jiz322/tiptoe-biped/data/p12_2_flight_20260827/README.txt

P12.2 flight recordings, 2026-08-27, policy K4b_3600 (10 trials).

Trial start condition:
- policy_K4b3600_log_20260827_164730.npz (the last one) starts WITH PICKUP
  (robot held / picked up at trial start).
- All other 9 npz files (163302 .. 164712) start ON THE GROUND.
