jiz322/tiptoe-biped/data/p12_2_flight_20260828_6pm/README.txt

P12.2-style flight recordings, 2026-08-28 ~6pm, policy R1r_3150 (8 trials).

Trial start condition:
- r1r_3150_log_20260828_180512.npz (the last one) starts WITH PICKUP
  (robot held / picked up at trial start).
- All other 7 npz files (180328 .. 180454) start ON THE GROUND.
