jiz322/tiptoe-biped/data/p12_3_flight_20260831_v/README.txt

P12.2-style flight recordings, 2026-08-31 ~15:02-15:04, policy R1r_3150 (6 trials).

Handover mode: ALL trials in this session were started with the 'v' key, NOT 'b'.
('v' = blind / training-contract handover: obs-history buffer zeroed like a
training episode start; 'b' = old deploy handover that fed the real frame x5.)

Trial start condition:
- r1r_3150_log_20260831_150405.npz (the last one) starts WITH PICKUP
  (robot held / picked up at trial start), as usual.
- All other 5 npz files (150243 .. 150352) start ON THE GROUND.
