jiz322/tiptoe-biped/data/p12_flight_20260825/README.txt

P12 flight recordings, 2026-08-25. Policies K4b_3600 (7 trials, 09:57-10:16)
and L1_4330 (5 trials, 10:37-10:38).
The day the right-knee belt tooth skip was first observed on video (after the
catch-steps on a grippy mat); see docs/p12-fall-isolation-runbook.md, whose
"forward lean" day verdict was retracted the same afternoon.

Contract at the time (see data/README.md for the decode rules):
- IMU pitch trim -0.089 (raw pg_x = logged - 0.089).
- Handover 'b' (sighted).
- IMU lateral sign constants were the OLD, mirrored set (fixed 2026-08-28).
