jiz322/tiptoe-biped/docs/p12-4-session-20260903.md

# P12.4 session report — 2026-09-03: IMU trim bracket, first sustained balance

Policy: R1r_3150 (TorchScript export of the R1r line, iter 3150), blind 'v'
handover (training contract, obs history zeroed), ground start, no pickup.
Recordings: `data/p12_4_flight_20260903_v_notrim/` (6 trials) and
`data/p12_4_flight_20260903_v_postrim/` (1 trial). Commits 423ace7 (trim 0) and
efdd12d (trim +0.089).

## 1. Decisions taken this session

- **`docs/p12-4-bench-runbook.md` abandoned by the user.** Too complex; most
  items not practically doable; designing bench experiments accurate enough
  costs days. Do not re-propose push-test / mass-added tap / video-annotation
  branches as prerequisites. The robot is now tuned empirically and flown.
- **Knee armature anomaly retracted.** The 09-01 tap frequencies (11 Hz @ kp30,
  14 Hz @ kp50) were double-counted. Corrected inertia is near the trained DR
  boundary, not 6× low. The 08-22 ballistic evidence (rotors ≈ 19e-3) stands.
- **IMU pitch trim `IMU_PG_OFFSET[0]` used as a control knob**, bracketed
  −0.089 → 0 → +0.089 in one day.

## 2. Trim bracket results

Sign rule (`control/config.py`): `pg_corrected = pg_measured − IMU_PG_OFFSET`,
so **raw pg_x = logged + OFFSET[0]**. Pitch = atan2(pg_x, −pg_z), positive =
forward. PONR25 = first crossing of 25° tilt never re-entered
(`data/_p12_3_alive_time.py` method).

| session (`data/`) | trim | raw pitch @0.2 s | plateau 0.3–0.8 s | PONR25 median | result |
|---|---|---|---|---|---|
| `p12_3_flight_20260831_v` | −0.089 | −13…−15° | −21°, rate −36°/s | 0.67 s | 5/5 fell backward |
| `p12_4_flight_20260903_v_notrim` | 0 | −10…−12° | −15°, rate −8°/s | 1.13 s | 6/6 backward, mostly tether-ended |
| `p12_4_flight_20260903_v_postrim` | **+0.089** | −6.5° | −10° | **none (6.06 s)** | **STOOD — still upright at log stop** |

Notes on the trim-0 session: the opening backward dive to ≈ −10° at 0.2 s is
trained behaviour and unchanged by trim; the trim changes the plateau
stability. Most trim-0 failures were tether-truncated (no backward room →
OOD); only trial 5 fell (backward lean) before the tether engaged.

### Post-trim trial `r1r_3150_log_20260903_134700.npz` (603 frames, 6.06 s)

- Raw pitch over 1–5.5 s: mean **−14.5°, sd 6.7°**; max tilt 34° once (3.4 s),
  never crossed 25° for good; last 0.3 s at −14°, still standing when the log
  stopped. First free-standing ground trial in the record to pass 4 s.
- Knees settled L +0.31 / R −0.32 rad (mirror signs → symmetric crouch), hips ≈ 0.
- The policy *perceives* pg_x ≈ −0.34 at that posture, close to its trained
  settled idle of −0.27 (08-25 analysis). With the old trim it held the same
  perceived value at a real pitch of −21° and toppled; now it holds it at
  −14.5° and survives → the knob places the real closed loop inside the
  policy's own basin.
- Plot: `outputs/p12_4_postrim_134700.png`.

### Right-knee belt slip (user-observed, mid-trial)

The npz cannot see slip directly (encoder is motor-side; checklist item 9),
but the data is consistent with the observation and dates it to ≈ [3.2–3.8]:

- Pitch rate −487°/s at 3.40 s; L knee |τ| 9.5 Nm motor at 3.17 s, R knee
  10.1 Nm at 3.76 s.
- Hip roll L/R in lockstep before 3 s (R − L = 0.00 ± 0.04 rad) vs a
  persistent R − L = +0.18 rad splay after 3 s; knees before L +0.242 /
  R −0.183, after L +0.326 / R −0.385 → right-leg geometry change followed by
  lateral compensation.
- The robot balanced ≈ 3 s more with one knee one tooth (12° = 0.21 rad
  joint-side) off — real robustness, and a hint about what the trim compensates.

## 3. Interpretation

- True IMU mounting offset ≈ −0.032 (08-18 crawl decomposition). The working
  trim is +0.12 past it: the policy must be told it leans ≈ 7° further back
  than it does. The trim is therefore a **plant-gap compensator, not IMU
  calibration**.
- Static CoM / mass model is **not** the lever: ≈ 0.3–0.37 kg unmodeled mass
  (W = 5.57 kg vs URDF 5.195) needs an 18 cm lever to shift CoM 1 cm; the
  knife-edge bounds |ΔCoM_x| ≲ 0.5–1 cm. Screws at the hip chassis cannot
  produce 7°. A mass-model fine-tune is not recommended.
- **Leading candidate: systematic knee joint-angle bias vs encoder** (belt
  slip / stretch / crawl-zero error). 12° knee × 0.2 m shank ≈ 4 cm foot
  displacement — the right magnitude, and tooth skips are observed.
  Independent check: Kinovea knee marker vs `sim_joint_pos`.
- Training-distribution holes found in `rl_env_cfg_p6.py` / `rl_env_p6.py`:
  `dr_com_offset_max = 0.015` is sampled **per link, per axis, independently**
  (`_dr_com_offset` shape `(num_reset, n_bodies, 3)`), so whole-body CoM_x std
  is ≈ 3–4 mm and never a coherent shift; `dr_mass_mult` 0.94–1.18 is
  location-less; `dr_proj_grav_bias_max = 0.10` is below the working +0.12.

## 4. Next steps (user-run hardware; n = 1 today)

1. Re-seat/re-tension the right knee belt; crawl-pose zero check before every
   trial (mandatory since 08-25).
2. 5–6 repeats at +0.089 for a survival number.
3. One bracket step at +0.13 (pre-registered: expect some degradation — that is
   +0.16 vs true mounting, past the trained ±0.10 band). Goal: find the forward
   edge, deploy at the window center.
4. Give the robot backward room (tether ended most trim-0 trials).
5. Retrain per the accumulated directive (memory `next-training-directive`):
   coherent whole-body CoM_x DR ±2–3 cm; per-leg knee-angle-bias DR ±0.1–0.2
   rad; static-lean reset DR at zero rate (fixed-point dead zone); handover
   contract randomization; `dr_proj_grav_bias_max ≥ 0.12`; mass recenter
   ×1.072. Continue from the R1r checkpoint and re-pass every override on
   resume.

## 5. Housekeeping done

- `CLAUDE.md` checklist item 8 rewritten: trim history and the per-folder
  raw-decode rule (−0.089 before 09-03; 0 for `_v_notrim`; +0.089 from
  `_v_postrim` onward).
- Memory updated: `p12-4-notrim-flight` (bracket table + belt-slip window +
  knee-bias hypothesis), `p12-4-decision-tree` (abandoned; surviving facts),
  `knee-armature-tap-contradiction` (retracted), `next-training-directive`
  (items 4–6 added).
- **Not done:** the comment block above `IMU_PG_OFFSET` in
  `control/config.py` (~lines 214–258) still says "STAYS −0.089" and is stale;
  left untouched because the file is deployed on the Pi at a pinned commit.
  Rewrite it at the next commit.
