jiz322/tiptoe-biped/docs/replant-report-20260817.html

# Replant Bench Report

Execution report against the Replant Runbook — what was measured, what died, what leads.

DATE 2026-08-17 → 08-18 (4 sessions + review) TAG pre-replant-20260817 BUS CAN2SPI, zero pacing ROBOT big_thigh biped, tether-hung (no stand — see review)

Four bench sessions executed runbook Phases 0–6. The headline: the plant's latency panel is an order of magnitude faster than every number the sim was calibrated against, and every mechanistic plant-side fall suspect died under measurement — the spd_filt_gain kd-lag hypothesis, the EL05 reference filter, and the RS01 current-clamp torque ceiling. What survives: the partial static bias and the un-caught launch transient.

A pre-Phase-7 review pass (08-18, no reruns) then audited all of it. Read the Phases 0–6 review before writing anything into the cfg: three claims above are corrected there, armature turns out to be the gating unmeasured field, and the viscous-friction DR band is 7× too narrow to contain the measured joint — itself a live candidate for the plant gap this campaign is hunting.

## Scoreboard phases 0–6 closed reviewed 08-18 — 7 corrections, 2 DR bands wrong

Phases 0–6 were re-audited on 08-18 against the raw captures without re-running any hardware. Chips below record what each session concluded; the review section records what survived that audit, and it revises seven published claims. Read the two together — three “closed” chips are ahead of their evidence, and the largest finding of the audit (viscous DR bands sitting below the measured plant) is new, not a restatement.

Phase | Item | Outcome
0 | Preflight | CLOSED — freeze tag, decode verified on hardware, six-motor firmware dump
1 | Loop timing | CLOSED — action 2.4–2.8 ms, IMU skew 2.0 ms, soak 100.00%
2 | Velocity / reference filters | CLOSED — kd filter ~0.7 ms (hypothesis dead); EL05 ref filter not live
3 | Torque ceiling & speed envelope | M3.1 CLOSED (ballistic probe, no load rig): full delivery to 17 Nm, clamp hypothesis dead. M3.2 envelope deferred — launch speeds sit deep inside it
4 | Step-response re-sysid | CLOSED (session 2, kp-sweep) — act_lag phantom on all three joints; ring is the kp-servo mode; no firmware loop lag on RS01, ≤13 ms confounded lag on hip_roll (stand compliance)
5 | Friction, inertia (bench) | CLOSED (session 3) — commanded-τ breakaway + M3.1-envelope ballistic fits; inertia "conflict" resolved as method bias; friction centrals measured; knee belt-off split pending
6 | Mass/balance | CLOSED (session 4, 08-18) — weigh-in +5.9% → recenter dr_mass_mult; init_h already fixed (0.4401, z=−0.01σ); straightedge declined (zero unverifiable) → substituted crawl-pose IMU decomposition: the −0.089 pg trim over-corrects by ~0.057; supine cross-check pending
7–9 | Env edits → replica gate → retrain | BLOCKED on 4–6; the P7 edit list shrank today

## Phase 0 — Preflight closed

- Freeze: ~100 uncommitted files snapshotted; tag pre-replant-20260817 (commit 500032b); all fitted numbers attributable.
- Velocity decode (the June ×1.136 bug): verified fixed on hardware, both motor families. Integral-method consistency: k = 0.9995 (RS01) / 1.0014 (EL05) — PASS at <0.2%. The naive slope regression read 2.03% and would have false-alarmed; timestamp jitter dilutes regression slopes (measurement-trap lesson re-confirmed).
- Reply pacing item was stale: superseded 08-16 by Phase D — each motor replies on its own ID, CAN2SPI_PACING_S = 0.0, and the bring-up guard verified 6/6 distinct live. Runbook text corrected.
- Firmware dump, all six motors, on the new bus (fw_livedump_all6_20260817.txt): zero per-unit spread. spd_filt_gain 0.100 ×4 RS01 / 0.500 ×2 EL05; limit_cur 23 A ×4 / 11 A ×2; zero faults. VBUS 30.2–30.65 V idle — the appendix's "~31.8 V, recheck" resolves to: the 30 V envelope assumption was right.

### New protocol facts (bank these)

- MIT-mode firmware ignores private-protocol extended frames even on CAN2SPI — the June finding was firmware behavior, not the USB adapter. Reads/writes require the protocol round-trip with a power cycle each way.
- spd_filt_gain is live-readable at runtime index 0x7021 (verified against the vendor CSVs). loc_ref_filt_gain has no CAN-reachable mirror at all (full scan 0x7000–0x7037) — vendor-tool-only.
- Vendor tool CSV export is broken → new verification path: read/set values in the GUI, verify over CAN with robstride_param_read.py (now speaks SocketCAN, has a guarded RAM-write mode).

## Phase 1 — Loop timing on CAN2SPI closed

Every CAN2USB-era number in cfg §12b is dead. The new plant is fast:

Measurement | Old assumption | Measured | Feeds
M1.1 action → motion onset, hip_pitch | 15 ms | 2.36 ms mean, 2.82 p95 (σ 0.36) | dr_action_delay → unchanged at 1 / 2 (⌈2.4 ms/10 ms⌉ = 1)
… knee (belt adds ~0.4 ms) | | 2.80 ms mean, 3.49 p95 (50/50 reps)
… hip_roll | | 2.62 ms mean, 4.36 p95
M1.2 encoder staleness vs IMU | IMU leads by 10 ms | IMU leads by 1.96 ms (corr 0.96) | dr_joint_delay 2 → 1 (skew is 0.2 tick, not 1); dr_imu_delay stays 1
M1.3 tick health, 600 s full traffic | — | 59,992 ticks, 100.00% replies, jitter p99 0.022 ms, busy p50 2.37 ms | accept ✓

Acceptance gates passed with wide margin (p95−p05 onset spread ≈ 1 ms vs the 10 ms control step). The hand-held roll rerun was discarded — hand resistance produced a 15 ms / 2 ms direction asymmetry, a useful reminder that the fits assume a free limb.

One flag from the soak: a single tick stalled 94 ms in the nn (policy inference) phase — 0.0017% of ticks, far under the 0.1% gate, and too rare to explain deterministic 0.16 s falls. Still: a ~9-period stall mid-launch would hurt. Recommend torch allocator / GC hardening before flight (Phase 10 list).

## Phase 2 — Filters closed spd_filt hypothesis

M2.1 verdict — three independent measurements agree The RS01 spd_filt_gain=0.1 EMA runs at the current-loop rate (~13 kHz): a 0.70 ms, |H|≈1.00 filter, flat to 25 Hz, corner ≈230 Hz — transparent where the balance loop lives. (1) M1.2 cross-correlation: telemetry velocity trails the position-derivative by 0.70 ms. (Review: raw arrays not retained; the M1.2 claim itself reads 1.96 ms. Unauditable — do not count.) (2) Chirp lock-in: 0.70 ms constant group delay at every frequency, both kd passes. (Review: independently reproduced at 0.704 ms ± 0.041 over 13 dwells. This one measurement carries the verdict, and it is enough.) (3) kd brake test: undershoot 3.4% at kd=2, none at kd=0.5, against a ≥13.6% counterfactual. (Review: 3.4% sits under 2 velocity LSBs and ~6× below the run's own 22% noise floor; the two kd conditions are statistically indistinguishable and the counterfactual collapses to ~0 at the engaged inertia. Withdrawn.)

- M2.2 (firmware A/B): moot. Nothing to raise; sim and firmware are already "matched" — the filter is negligible on both sides. No vendor-tool writes.
- M2.3 (EL05 loc_ref_filt_gain=0.04): not live in MIT mode. Position-step responses show no 20–50 ms filter. (Review 08-18: the published “1.7% rms, filter fitted to exactly 0 ms” does not reproduce — refit gives 21.6% rms with the prefilter pole pinned at its bound. The conclusion survives on a weaker basis: 27 ms of fitted rise buys only 0.4% of residual.) The hip_roll "most ring, lowest ω" act_lag fit is therefore an old-bus artifact — Phase 4's refit should confirm.
- Bonus physics retracted 08-18 — as published: hip_pitch inertia 8.48e-3 kg·m², “independently validating” the cfg's 8.4e-3 combined armature, pendulum stiffness 4.73 Nm/rad (3.8 Hz). Do not use. The real chirp pins stiffness at exactly 0.000 at 28–32% residual, and the quoted pair matches the fitter self-test's synthetic truth to 0.3%. Engaged hip inertia is 31e-3 (P5). See the review.

### Methodology notes for the remaining phases

- Hand-held-base data breaks rigid-plant fits (FRF chirp 28% rms, step control-fit 32%). If a test needs the torso held, design it so the discriminator lives in the first ~10 ms (brake test), or fixture the robot.
- Time-domain bounding beat FRF fitting on this rig: stiction (C ≈ 0.1–0.3 Nm, amplitude-dependent) and a rest equilibrium only known to ±40 mrad poison small-signal frequency-domain work.
- Synthetic self-tests first: the kd fit pipeline was validated on simulated data with known truth before touching real data — kept a sign-convention bug from becoming a wrong conclusion.

## Hypothesis board after today

Fall-cause candidate | Status | Evidence
kd-path velocity filter (spd_filt) | dead 08-17 | 0.7 ms, three independent measurements (this report)
Launch / IMU / DR coverage | dead 08-13 | hw-matched sim survives 6 s
Torque delivery softness (0.59–0.66) | dead 08-14 | telemetry artifact
Static balance-point bias (+0.075) | demoted 08-18 | P6 crawl-pose decomposition: ~0.057 of it is IMU-trim over-correction (hand-held-derived −0.089 vs crawl-derived −0.032 mounting); physical CoM residual ≈ +0.018, inside DR. Was already insufficient alone (≤5% die <0.5 s). Supine cross-check pending
RS01 current clamp: 12.9 Nm real vs 17 modeled | dead 08-17 | Ballistic torque probe (bursts vs known inertia): delivered tracks commanded 1:1 from 4→17 Nm, α/τ constant with no break at 12.9 — full delivery in the launch-relevant transient regime. Effective Kt ≈ 0.74 Nm/A, not the 0.562 used in the 23 A × Kt arithmetic. saturation_effort 17/23.2 validated. (Sustained-stall thermal derating not probed; no falls-relevant mechanism.)
Rotor off-diagonal belt coupling + 4× armature | LEAD (P7, 08-18) | Missing hip torque the size of the hip's own commands, peaking at the 0.161 s fall-initiation window (fall-log replay); requires two-joint acceleration — invisible to every single-joint bench. With it in the plant, hw_matched flips from surviving 6 s to 512/512 pitch-first falls, 83% one-signed in the hardware direction (Phase 8 first pass). Timing spread still wider than hardware's 0.25 s cluster.
Un-caught launch transient | open, demoted | still a candidate for the residual timing mismatch; no longer needed to explain the fall itself

## Phase 7 edit list — updated sources

Field | Now in cfg | New source
dr_action_delay_min/max | 1 / 2 | KEEP 1 / 2. Corrected: an earlier draft here read “0 / 1”, which is wrong twice over. The runbook's own mapping rule is min = measured floor rounded up, max = floor + 1 step, and ⌈2.36/10⌉ = 1 → 1 / 2. Separately, min=0 would revert a deliberate change (rl_env_cfg_p6.py:946, “was 0 — never instant”): a 10 ms control period plus 2.4–2.8 ms transport is never a zero-delay path, and letting the sim sample 0 lets the policy learn a reflex hardware cannot honor. M1.1 shrinks the old 15 ms assumption to ~2.4 ms, but both round into the same 1-step bucket, so the tap does not move.
dr_imu_delay_* | 1 / 1 | KEEP 1 / 1. Locked at 1 on purpose (:951-953 — a zero-latency balance loop was the 2 Hz wobble). M1.2 does not challenge it.

dr_joint_delay_*

2 / 2

2 → 1 / 1. This is the one delay tap M1.2 actually moves. The cfg holds joint at 2 explicitly “so encoder feedback stays ~10 ms behind the IMU, matching the measured skew” (:956-958) — but that rationale predates M1.2. The measured skew is 1.96 ms, not 10 ms: 0.2 of a tick, which rounds to no relative offset. Carrying joint one full tick behind the IMU overstates the real skew by ~5×. Set both paths to 1. Caveat: M1.2 pinned the relative skew only; absolute per-path staleness was never measured (see the gaps table), so 1 comes from the runbook's round-up floor rather than from a direct measurement.
new kd velocity EMA | planned | DROP — 0.7 ms is inside delay-DR granularity (M2.1)
new hip_roll ref filter | planned | DROP — not live (M2.3)
act_lag_* | ω 21/37.9/27.6 | act_lag_enable=False — CONFIRMED (P4 kp-sweep, session 2: ring moves with kp, prefilter transparent, M1.1 onset 2.4–2.8 ms); drop dr_act_lag_* with it
saturation_effort hp / knee | 17 / 23.2 | KEEP — validated by ballistic probe (M3.1, transient regime)
velocity_limit | 28 / 27.5 / 20 | M3.2 (VBUS 30.5 V measured; fw limit_spd 44/50)
friction (Coulomb) | 0.12 / 0.06 / 0.12 | P5 measured, joint-space — 0.146 / 0.177 / 0.187 (hp/knee/roll). Knee is 0.130 motor ×1.364 and lands outside its 0.03–0.12 DR box; widen it. Knee awaits the belt-off split before writing.
dynamic_friction | 0.10 / 0.05 / 0.10 | P5 measured, joint-space — 0.144 / ≈0.22 / ≈0.20. Ckinetic ≈ Cstatic on hip (cross-validated); knee value is polluted by hip reaction through the belt, so it is provisional.
viscous_friction | 0.003 all | P5 measured, joint-space — 0.043 / 0.029 / ≈0. Both hip_pitch and knee sit outside the 0.0015–0.006 DR box (7× and 4.8×); the band must widen, not just recenter. Decide a nonzero floor for roll or the ×0.5–2 DR keeps it at zero.
armature | 8.4e-3 / 7.81e-3 / 7.0e-4 | NOT YET COMPUTED — the gating field. Needs Iengaged − IURDF-link per axis; measured Iengaged is 31–40e-3 hip / 20.7e-3 knee motor (= 38.5e-3 joint) / roll unresolvable on this rig. Do not write Iengaged into this field. Watch the hip double-count: the cfg's 8.4e-3 already carries the knee rotor reflected through the belt (c²·7.81e-3), and the belt-on measurement contains it too. The 8.4e-3 pendulum agreement was rotor-side small-signal, not a validation.
dr_mass_mult_min/max | 0.88 / 1.12 | 0.94 / 1.18 (P6 weigh-in: hw 5.5 kg = URDF ×1.059)
dr_proj_grav_bias_max | 0.03 | KEEP 0.03 if IMU_PG_OFFSET is recalibrated to ≈−0.032 (P6: physical residual ≈+0.018); if the −0.089 trim stays, must train ≥0.1 as G2i did

## Phase 4 — Step-response re-sysid closed (session 2) act_lag

Existing M2.3 step data answered most of M4.1 without new motion; a kp-triplet battery per joint (user-run, same pose, single sitting) supplied the discriminator. Fits by data/step_lag_fit.py and data/kp_sweep_fit.py, both synthetic-validated (the kp-sweep self-test recovers a planted 30 ms loop delay exactly and separates models at 0.13% vs 40% vs 1400% rms).

M4.1 verdict — act_lag_enable = False, all three joints Three independent falsifiers agree. (1) The step ring frequency moves with kp (e.g. knee 25.9 → 33.0 → 44.5 rad/s for kp 8/16/32) — it is the closed-loop servo mode, not a command prefilter, whose ring would sit at a kp-independent frequency. (2) M1.1 already measured 2.4–2.8 ms action→onset on every joint; a ω≈21–38 rad/s prefilter would show 25–50 ms. (3) Joint fits offered a free prefilter drive it transparent and gain <10% of residual. The old fits (ω=21/37.9/27.6) were the plant's own kp-servo ring seen through old-bus latency and misattributed to the command path.

Joint (motor-space) | Best model | rms | I | b (Nm·s/rad) | C (Nm) | Extra loop lag
hip_pitch 101, kp 4/8/16 | rigid | 7.5% | 19.8e-3 † | 0.217 † | 0.038 | none (t_l → 0)
hip_roll 103, kp 3/6/12 | fbfilt (marginal) | 12.3% | 31–34e-3 | 0.04–0.22 | ~0.11* | 11–13 ms, confounded — see below
knee 102 (belt-on), kp 8/16/32 | rigid | 10.5% | 15.2e-3 | 0.035–0.055 | 0.12–0.14 | none (t_l 0.5 ms)

*hip_roll Coulomb from the model-free settle sweep: the settle deficit scales exactly as C/kp across kp 3/6/12 (C = 0.108/0.120/0.092 Nm) — it is stiction, not a gravity spring. Knee's C≈0.13 vs hip_pitch's 0.04 is the belt drag showing up where it should (P5 will split belt-off/on). Review 08-18: the roll curve-fit C is 0.009 in the winning model and never exceeds 0.068 in any of the three — the ~0.11 above is the settle-sweep number only. The fbfilt “win” is a b↔C trade (b 0.043→0.219 as C 0.068→0.009) for 1.0 pt of rms, not a lag detection. P5's breakaway 0.187 is the number to carry.

† Superseded — do not pull from this row. P5's engaged measurement puts hip_pitch at I = 31.0e-3 (bootstrap CI 29.6–32.8) and b ≈ 0.04, so the kp-sweep b = 0.217 is high by ~6× and its I low by ~1.6×. The hip_roll row's 31–34e-3 is still the recommended central (P5 could not resolve roll inertia on this rig); the knee's I is superseded by ≈21e-3. Three statuses in one table — read the review before writing any of it into the cfg.

Base-condition sensitivity (hip_roll): a deliberate perturbation during capture — hand-supporting the torso so the chassis tether went loose — moved overshoot roughly 2× vs tether-tight. The stand/tether participates in the roll mode, so hip_roll's fitted I and its marginal 11–13 ms "lag" carry an asterisk; the RS01 joints show clean kp-scaling and no lag, so the effect does not contaminate the headline verdict. Remaining bench captures should be run tether-tight, hands off, one condition per battery.

Inertia: narrowed, not resolved. The kp-triplet fit puts hip_pitch at 19.8e-3 (single-kp fits: 15–16e-3) vs the M3.1 ballistic ≥43e-3 — same near-zero pose per the operator, so the earlier pose-dependence reconciliation is dead and the gap (now 2.2×, was 5×) is method-dependent. P5's coast-down gives a third, independent method; resolve there before feeding sim armature/link inertia (Phase 8 gate input).

## Phase 5 — Friction & inertia bench closed (session 3)

All captures tether-hung, commanded-τ only (June's friction_id.py is superseded — it used torque_fdb as truth). Two protocols, both synthetic-validated before real data: a slow τ-ramp breakaway (gravity cancels by direction symmetry) and an M3.1-envelope ballistic battery (coast_down_bench.py --mode ballistic: strictly alternating short bursts, levels 1–4 Nm, logged PD brake, offset-start reps). Fit: data/coastdown_fit.py burst-primary regression, 8 selftest cases.

Headline — the 19.8 vs ≥43e-3 inertia conflict is method bias, not physics Burst traces exposed a lash-engagement onset transient on hip_pitch (first ~20 ms the rotor accelerates alone at ~τ/12e-3 through gear lash, then dumps momentum into the leg). Synthetic replay proved (a) the M3.1 naive slope method inflates I under damping+lash (a planted 20e-3 reads 42.9), and (b) the kp-sweep's small-signal ring rides the rotor side of the lash. Engaged large-signal inertia, the launch-relevant number: hip_pitch 31–40e-3 (burst fit 31, naive bracket 39–40), knee belt-on ≈21e-3 (vs kp-sweep 15.2 — same ~35% engaged-vs-small-signal pattern on both RS01 joints). The two-mass (rotor–lash–leg) character itself is now a live candidate for the un-caught plant gap.

Joint (motor-space) | I engaged | C static | C kinetic | b (Nm·s/rad) | Notes
hip_pitch 101 | 31–40e-3 | 0.146 | 0.144 | 0.03–0.04 | C_k = C_s cross-validation; kp-sweep b=0.217 was artifact — b is SMALL
knee 102 (belt-on) | ≈21e-3 | 0.130 | ~0.12–0.14 | ~0.02 | ballistic C polluted by dynamic hip-reaction through belt (held hip yields ∝τ) — C from breakaway + P4 preview; belt-off split pending
hip_roll 103 | 26–40e-3 (unresolved) | 0.187 | ~0.20 | ~0 | friction well-measured (±0.004!); inertia unresolvable on this rig — tether damps the roll mode (R² 0.41), hand-held adds base motion (R² 0.65, biased breakaway). Keep P4's 31–34e-3 central, wide DR

Capture lessons (paid for twice): the tether-hung torso is a free-floating base — sustained torque swings it, window bounds lie, and the thigh found the torso hard in both a wide-travel coast and a constant-τ ping-pong. The ONLY validated envelope on this rig is M3.1's: strictly alternating short bursts, tight travel, immediate brake, stall guard (never press into contact). One-way bursts alias viscous b into the gravity slope (fit returned b=−0.15) — offset-start reps that burst through home are mandatory. Every fit change was synthetic-validated before touching real data; the selftest caught two real bugs (SG-window smearing: 8% I bias; the b/g1 degeneracy) before they could ship wrong numbers.

## Phase 6 — Mass, balance point, init_h closed (session 4)

Executed 2026-08-18. The straightedge balance test was consciously dropped: with no independent way to verify the joint zeros, it cannot separate its own error sources (operator decision; revisit if the next CAD revision adds zero-position fixtures). Its job — decomposing the +0.075 static bias — was done a different way, using the crawl pose as a self-supporting attitude reference.

### M6.1 — Weigh-in

Hardware as flown: 5.5 kg (operator scale). URDF/USD link total: 5.195 kg → hardware is +5.9%, past the 5% recenter threshold. P7: recenter dr_mass_mult from [0.88, 1.12] to [0.94, 1.18] (same ±0.12 width, centered on 1.059). The missing ~0.30 kg is unmodeled hardware (battery, cables, boards) whose location is unknown — it also shifts CoM, so keep dr_com_offset DR honest rather than shrinking it.

### M6.3 — init_h

Already closed by the 08-16 config fix; verified analytically (data/_p6_init_h_check.py). Training init_h = FK height with ±0.08 rad orientation noise → mean 0.4401, std 0.0058 — matches the checkpoint normalizer's slot-31 stats exactly. The old deployed SPAWN_HEIGHT=0.434 lands at z=−1.05σ — this was the entire −1.07σ obs-contract finding. The current deployed 0.4401 lands at z=−0.01. No physical measurement needed; the channel is a constant the policy compares against a constant.

M6.2-substitute verdict — the −0.089 IMU trim over-corrects by ~0.057; most of the +0.075 "static bias" is an obs-trim artifact The crawl pose is self-supporting (floor + geometry set torso attitude — no hands, and the robot is zeroed at crawl so the pose is the zero reference itself). Hardware, motors unpowered, 15 s IMU log (control/crawl_imu_log.py): RAW pg = (+0.0957, −0.0045), sd 0.0003, zero drift — rock solid. Sim replica of the same rest (data/_crawl_imu_reference.py, strong-PD hold, seeded near the hardware attitude): the converged basin reads pg = (+0.1280, −0.0033), four envs agreeing to ±0.0002. Difference = IMU mounting offset ≈ (−0.032, −0.001) — a third of the deployed IMU_PG_OFFSET = −0.089, which came from hand-held standing launches (the same hand-held data class every bench phase has had to discard). Propagating to the 08-13 knife-edge measurement: raw balance-point attitude = +0.075 − 0.089 = −0.014; subtracting the crawl-derived mounting offset leaves a physical forward-CoM bias of only ≈ +0.018 (≈1.0°) — inside the trained bias DR. Under the deployed −0.089 trim the policy sees the balance point at +0.075; under a −0.032 trim it would see +0.018.

- Uncertainty: the sim crawl rest carries collision-mesh and settled-pose error (sim settled ±0.07 rad off nominal crawl; rest pitch 7.4° vs hardware 5.5°). Read the mounting offset as −0.03 ± 0.03: even the pessimistic end says the −0.089 trim over-corrects.
- Cheap discriminator (2 min, user): flip the robot on its back (motors off) and run python crawl_imu_log.py --tag on_back. Sim reference: pg = (−0.9685, 0.0000, −0.2489), converged to ±0.0002 and independent of legs/zeroing entirely (single rigid torso). Compare pg_z (x is cos-suppressed at that attitude): a mounting pitch δ shifts pg_z by ≈0.97δ, so the −0.032 hypothesis predicts hardware pg_z ≈ −0.218 vs −0.249 sim. Offsets agreeing across crawl and supine ⇒ fixed mounting rotation, subtract with confidence; disagreeing ⇒ contact-geometry error, keep the trim empirical.
- Do not edit IMU_PG_OFFSET yet — the fall replays (Phase 8 gate) must run against the contract the falls were recorded under. Recalibration is a Phase 10 item, after the supine check.
- Fall-mechanism note: the over-trim makes the policy believe it leans forward more than it does; its correction pushes the CoM back — yet hardware falls pitch-forward. The static bias was already insufficient in the sim sweep (≤5% die); this reframing further demotes it. The un-caught launch transient and leg-coupled dynamics remain the live suspects for Phase 8.

## Next — remaining before Phase 9 P9 LAUNCHED 08-18

- P9 running: fresh train, lineage p9_replant (RL/logs/rsl_rl/p9_replant/), 32768 envs, entropy 0.003 / desired_kl 0.008 (fresh values), pg-bias DR ±0.10 — see next item. First iterations healthy (banner: act_lag OFF, joint delay 1, mass ×[0.94,1.18], DR write path alive).
- Supine IMU cross-check: DEAD — physically impossible (operator: the Pi and its wiring live on the torso's back; the robot cannot rest there, and propping it would measure the prop). Consequence, decided 08-18: IMU_PG_OFFSET stays at the deployed −0.089 (falls-replay contract preserved, no hardware change), and P9 trains with dr_proj_grav_bias_max = 0.10 — the G2i (…_imuoffset010) recipe that already flew. The crawl-derived mounting estimate (−0.032 ± 0.03) stays on record, unconfirmed; revisit only if a second self-supporting attitude ever becomes available (e.g. a motor-held kneel, operator-run).
- Knee belt-off: DOWNGRADED — not worth the disassembly. The belt (PU+steel) only comes off with the thigh, so the direct rotor measurement is not cheap. The no-disassembly 80% substitute: rerun the knee ballistic with the hip held stiff — python coast_down_bench.py --motor 102 --hold 101 --hold-kp 40 --tag belt_on_stiff (new flag, synced to the Pi). If the fitted I drops toward ~15e-3, the 19.4e-3 excess was hip-yield coupling; if it stays ~19–21e-3, the knee rotor genuinely reads high (per-unit or τ-scale) — either way inside the trained armature DR (×0.7–1.3 spans 25–47e-3 about the 36e-3 central). Optional, mid-training, operator-run. Take the true belt-off data opportunistically if the thigh ever comes off for other reasons.
- M3.2 speed envelope (still deferred): launch speeds sit deep inside the measured full-torque region.

Where the fall hunt stands after today: every plant-side suspect with a proposed mechanism is now dead (filters, delivery ratio, torque ceiling, limits, launch/IMU/DR) except the partial static bias and the un-caught launch transient. That raises the stakes on P4–P6 precision and on the Phase 8 replica gate: if the refreshed plant still balances where hardware falls, the gap is in something no single-joint bench test excites — leg-coupled dynamics, contact, or the launch sequence itself.

## Phases 0–6 review audit 08-18, no reruns

Pre-Phase-7 completeness and correctness pass over everything above: runbook coverage, internal consistency, and independent recomputation from retained raw data. Nothing below is a new experiment. Three claims are corrected, two gaps are hard blockers, and one previously unflagged finding changes what Phase 7 must write.

### What survives verification

- Engaged inertia is solid. Pooling the two well-conditioned hip_pitch ballistic runs (bal2+bal3, 926 burst samples, 9 torque levels each direction) gives I = 31.0e-3 with a rep-bootstrap 5–95 CI of 29.6–32.8e-3 (±5%). Knee 20.7e-3 (CI 19.6–21.8). The P5 headline figures are reproducible.
- M1.3 soak reproduces exactly from the retained per-tick CSV: 59,992 ticks, 100.0000% six-of-six replies, busy p50 2.371 ms, one 95.8 ms stall.
- M2.1's 0.70 ms is genuinely measured. Independent per-dwell lock-in on kdchirp_101_2 gives 0.704 ms mean (sd 0.041, 13 dwells), 0.7% from the one-pole prediction for α=0.1 at 13 kHz. The spd_filt hypothesis stays dead on this evidence alone.
- Breakaway Cs is correctly computed and correctly sourced. The direction-symmetry cancellation at friction_breakaway.py:15 is sound (both directions yield opposite-signed torques; symmetric and magnitude formulas agree to 4 digits), and the report quotes brk_103_hang (0.187) rather than the degenerate hang_hold. Published C values stand.
- P6 mass and init_h. +5.9% recentring of dr_mass_mult to [0.94, 1.18] at fixed width is exactly the runbook's instruction; init_h verified against SPAWN_HEIGHT = 0.4401.

### Corrections to claims above

Claim as published | Correction
M2.3 “1.7% rms, ref filter fitted to exactly 0 ms” | Does not reproduce. The only available fitter on step_103+step_103_2 (32 reps) gives 21.6% rms, and the prefilter lands at a 27.2 ms rise with zp pinned at its upper bound — an at-bound optimizer artifact, not a measurement. The conclusion likely holds (27 ms of rise buying 0.4% of residual is not evidence of a real filter), but the stated evidence is wrong and “fitted to exactly 0 ms” should be struck.

Bonus physics “8.48e-3 / 4.73 Nm/rad, independently validating the cfg's 8.4e-3”

Retract. Refitting the real chirp pins kg at exactly 0.000 in every subset at 28–32% residual, so 4.73 Nm/rad has no support in that dataset. The reported pair sits within 0.3% of the fitter self-test's synthetic truth (8.50e-3, 4.70). Most economical reading: self-test output was transcribed as a real-data result. Separately, even the charitable reading compares unlike quantities — a small-signal rotor-side FRF against a composite armature (own rotor 4.2e-3 + knee rotor reflected c²·7.81e-3). The numerical agreement was coincidence, and it closed a P5 checklist item early, suppressing the ~4× gap P5 then found.
kd brake “3.4% undershoot at kd=2, none at kd=0.5” | Below the noise floor; supports nothing. Settled-tail velocity sd is 0.084 rad/s = 7.4% of vpeak, giving a ~22% pure-noise undershoot floor — 6× the claimed effect; 3.4% is under 2 velocity LSBs. The two kd conditions are statistically indistinguishable, and at short windows kd=0.5 is the larger. The 13.6% counterfactual exists only in this HTML, depends on I=8.48e-3, and collapses to ~0.00% at the engaged 31e-3. Drop this from “three independent measurements” — M2.1 rests on the chirp lock-in, which is enough.

M1.1 “N≥50 both directions”

hip_pitch's 2.36 ms rests on 30 single-direction reps — all 30 + reps failed onset detection and lat_101.npz stores an empty results array. Detector failures are direction-skewed on every joint, so survivors are a biased subset. Also lat_103_2, cited as source data, gives mean 9.10 ms / p95 19.50 ms and fails the 10 ms gate; only the agreeable run is quoted. Finally the detrended-quadratic onset method biases +1 to +2 ms late (synthetic ground truth), so true dead time is ~1–2 ms below the quoted figures. All three effects are small enough that the 0–2 tick mapping survives, but the numbers are upper bounds, not estimates.

M3.1 “full delivery to 17 Nm, effective Kt ≈ 0.74, saturation_effort validated”

Partly circular. The probe infers τ from I·α with a self-derived I, and P5 later revised that same inertia; rescaling by 31/43 turns “17 Nm” into ≈12.3 Nm, landing on the 12.9 Nm clamp the report declares dead. The Kt figure is arithmetically just 17/23 = 0.739, i.e. what you get by assuming full delivery at the ceiling. What genuinely stands is the shape result — α ∝ commanded τ with no break at 12.9 — which does falsify a clamp engaging inside the swept range, and the independent physics argument for ~full delivery is on record elsewhere. Re-derive delivered τ with P5's engaged I, and cite the physics argument rather than the Kt number.
Phase 7 row, dr_action_delay “→ 0 / 1” and the delay taps “→ 0–1 tick” | Wrong direction; fixed in the row above. The runbook's mapping rule is min = measured floor rounded up, max = floor + 1, so ⌈2.36/10⌉ gives 1 / 2 — the values already in cfg. Proposing 0 would also revert two deliberate locks (:946 “was 0 — never instant”; :951-953 the zero-latency IMU reflex that produced the 2 Hz wobble); a 10 ms period plus ~2.5 ms transport is never instant. M1 shrinks the assumption from 15 ms to ~2.4 ms without moving the bucket. The one tap that does move is dr_joint_delay 2 → 1: it was held at 2 to model a 10 ms IMU-vs-encoder skew that M1.2 measures at 1.96 ms.
Phase 4 table, hip_pitch b = 0.217 | Superseded by P5 (b ≈ 0.03–0.04) and already called an artifact at the P5 headline — but the P4 table carries no annotation, so anyone pulling numbers from it is off by 6×. Same table's I values are superseded for hip/knee while its hip_roll 31–34e-3 is kept as the P5 central: one table, three statuses, unmarked.

### The friction split is not identifiable — and two DR bands are wrong

Recomputation shows C and b trade off along a near-null direction (weakest singular vector loads −0.57 on C against +0.74 on b; corr(sgn v, v) = +0.70 because captures are mostly one-directional at high speed). Consequences: hip_pitch b flips sign between two runs of identical configuration (bal2 −0.045, bal3 +0.041), and pinning C at the breakaway value does not rescue it. Knee ballistic C comes out negative with its whole CI below zero, which is unphysical and independently confirms the report's own “polluted by hip reaction through the belt” caveat. Two of the four hip_pitch runs (bal_101_kneeheld, kneelimp) are simply under-conditioned — 133–148 samples over 6 levels with a gap between −2 and +2 Nm — and should not be quoted at all.

What is robust is the pooled hip_pitch viscous term: b = 0.043, CI 0.008–0.062, which excludes zero. Against the cfg:

Field | cfg central | DR box (×0.5–2.0) | P5 measured, joint-space | Verdict
viscous_friction hip_pitch | 0.003 | 0.0015–0.006 | 0.043 | 7.1× above the ceiling
viscous_friction knee | 0.003 | 0.0015–0.006 | 0.029 (0.016 motor) | 4.8× above
friction knee | 0.06 | 0.03–0.12 | 0.177 (0.130 motor) | 1.5× above
friction hip_pitch / hip_roll | 0.12 | 0.06–0.24 | 0.146 / 0.187 | inside

Both knee rows are reflected through G² and G respectively — the cfg fields are joint-space, so a motor-space comparison understates the knee by 1.86× on viscous and 1.36× on Coulomb. Quoting the knee in motor-space is exactly the mistake the next section warns about, and it flips the knee friction verdict from “negligible” to genuinely outside.

So the runbook's premise — “the 0.5–2× DR likely covers reality; today we move the centers, not the bands” — is falsified for the viscous term. Hip Coulomb is fine; the knee's is not. Every policy above was trained with viscous damping at most 0.006 while the joint measures 0.043; the bands must move, not just the centers. This is a live candidate for the plant gap the campaign is hunting, and it was not previously flagged.

### Unit convention — the write-time hazard for Phase 7

Isaac Lab's armature, friction, dynamic_friction, viscous_friction are per-DOF joint-space tensors (actuator_base.py:94-104). Every P5 number above is motor-space. hip_pitch and hip_roll are direct-drive so they transfer unchanged, but the knee needs G = 22/30 = 0.7333: Ijoint = I/G² (×1.860), Cjoint = C/G (×1.364), bjoint = b/G² (×1.860). A naive write is wrong by those factors — knee C 0.130 → 0.177, knee b 0.016 → 0.029, knee I 20.7e-3 → 38.5e-3. The cfg already uses joint-space with exactly these reflections (knee armature 7.81e-3 = 4.2e-3/G², saturation_effort 23.2 = 17/G, velocity_limit 20 = 27.5·G), which is how the convention was confirmed. belt_knee_actuator.py contains no G at all and offers no protection: whatever is written into the knee column is interpreted as knee joint properties, and c enters only the velocity used for the DC envelope, never the friction or armature terms.

Two traps follow. (1) Knee friction 0.06 and dynamic_friction 0.05 sit below hip's 0.12/0.10 where the reflection demands above — a pre-existing wrong-direction belt conversion (0.12 × 0.5), inconsistent with the armature convention three lines up. Recompute these; do not preserve the ratio. (2) The cfg's 8.4e-3 hip armature deliberately includes the knee rotor reflected through the belt anchor (c²·7.81e-3 ≈ 4.2e-3), and P5's engaged hip inertia was measured belt-on, so it already contains that same term. Writing Iengaged − Ilink while keeping the reflection counts the knee rotor twice.

### Coverage gaps

- Phase 0 safety items never mentioned: “robot on the stand, e-stop tested, spare fuses at hand.” E-stop function was never verified in a campaign that ran 17 Nm bursts. Worse, the stand is asserted in the meta header (“on stand”) and used to explain hip_roll's 11–13 ms lag as “stand compliance”, while the body states all captures were tether-hung and the torso a free-floating base. That is a different and worse confound, and it makes the runbook's Phase 10 re-entry protocol (hang → supported stand → free stand) unexecutable as written.
- make_legacy_actuators is in no edit list. The runbook says centrals go in both actuator factories. That path is what sysid_replay_policy_log.py --actuator legacy uses, and Phase 8's replica gate runs through it — updating only the belt factory leaves the A/B arm on stale friction. (_hip_roll_actuator() is shared, so roll propagates for free; hip_pitch and knee do not.)
- Dropping dr_act_lag_* removes 12 privileged-obs dims. priv_obs_dim = 78 must go to 66 or the dims must be pinned at 1.0, and the drop touches rl_env_p6.py at the DR key list, critic slices, sampling, logging, and _priv_perm/_priv_sign. It is a decision, and it is missing.
- armature is the gating unmeasured field. What exists is engaged joint inertia; the sim needs Iengaged − IURDF link, still listed as next-session prep. Knee awaits belt-off, hip_roll's I is declared unresolvable on this rig, and rotor-alone ~12e-3 vs cfg 4.2e-3 is unreconciled.
- M1.3's gated quantity was never reported — the gate is “<0.1% of ticks over 10 ms” and the procedure asks for a >5 ms outlier count; what was reported is reply completeness and busy p50. Also “3.6 ms nominal” vs busy p50 2.37 ms is left unreconciled (different quantities; 59,992 ticks / 600 s confirms the period is 10 ms). M1.2's raw arrays were not retained at all, so 1.96 ms and r=0.96 are permanently unauditable — and the M2.1 verdict box cites M1.2 as 0.70 ms while the M1.2 claim itself is 1.96 ms. M1.2 also delivered only the relative skew — the runbook additionally asked for absolute per-path staleness by pairing with M1.1's clock, which was never reported. That is why the corrected dr_joint_delay = 1 rests on the runbook's round-up floor rather than on a measured per-path number; both paths round into the same bucket either way, so the write is safe, but it is not measurement-backed.
- M2.1 was never stated for the EL05. The verdict names the RS01's spd_filt_gain=0.1; hip_roll's 0.5 is cleared only by inference.
- dr_proj_grav_bias_max has an ordering inversion. Keeping 0.03 is conditional on an IMU_PG_OFFSET recalibration deferred to Phase 10, resting on a finding that still awaits the supine check. Phase 9 would train against a hardware change scheduled after training, contingent on a test not yet run. If the supine check kills the finding, the run is wasted.

Net effect on Phase 7 readiness: the “closed” chips on Phases 3, 5 and 6 are ahead of the evidence — P3 has M3.2 deferred, P5 has the belt-off split pending and hip_roll's I unresolvable, P6 has the supine check pending. Of the fields P7 must write, only dr_joint_delay (2 → 1, the sole tap M1 actually moves — the other two stay put) and dr_mass_mult are measured and unambiguous; saturation_effort needs re-deriving against P5's inertia, the friction fields need the belt-space conversion plus widened viscous bands, and armature is not yet computed. Recommended order before P7: (1) fix the viscous DR bands, since that is the one finding that could itself be the plant gap; (2) compute armature properly, watching the double-count; (3) the two short hardware items already listed (knee belt-off, supine IMU); (4) settle one number per cfg field — the P7 row and the P5 table currently disagree in the third digit on C and b.

## Phase 7 — Env & actuator edits shipped (session 6, 08-18) rotor coupling found

Commit 2d0441f. The armature computation the review called the gating field turned into the biggest finding of the campaign: the rotor-side inertia is 3–4.6× the assumed vendor number, and its off-diagonal belt-coupling term — absent from every sim the policies trained in — is a hip torque the size of the hip's own commands, peaking at the fall-initiation time.

### Armature decomposition (bench modes vs URDF links)

Full 3D FK over the URDF chain (data/_p7_armature_from_urdf.py) puts the link contribution at only 17.1e-3 of the measured 31.0e-3 hip mode and 2.50e-3 of the knee's 38.5e-3 joint-space total. The URDF's first moments check out against the bench gravity slope (0.913 vs 0.985 Nm/rad — the 7% shortfall matches the +5.9% weigh-in), so the deficit is rotating inertia, not link mass. Solving both benches:

Quantity | Value | Corroboration
Ir hip RS01 (output) | 13.9e-3 (CI 12.5–15.7) | P5 lash transient: rotor alone at ~τ/12e-3
Ir knee RS01 (output) | 19.4e-3 (CI 18.3–20.5) | kp-sweep small-signal 19.8e-3 = the rotor side of the lash
Model closure | reproduces knee-held 30.9e-3, knee-limp 30.6e-3 (Schur), knee-mode 38.5e-3 — and predicts the P5 "held vs limp changed nothing" observation. The old 4.2e-3 assumption predicts 21e-3 for both, 10e-3 below the bench.

New cfg armature (both factories): hip 33.2e-3 (13.9 own + c²·36.0 reflected), knee 36.0e-3 (Ir/G²), roll 7.0e-3 (P4 total 31–34e-3 − URDF links 25.2e-3, tether-confounded → wide DR). Previous values 8.4 / 7.81 / 0.7e-3 — the armature DR box (×0.7–1.3) never contained the real plant, same finding class as the viscous band. Caveat carried in the factory header: all commanded-τ benches share the per-motor torque-scale degeneracy; armature here calibrates commanded-τ → q̈, which is exactly what the replica drives with. Hip-vs-knee rotor estimates differ 40% (same motor model) — dr_armature_mult kept wide and retagged LOW→HIGH.

The off-diagonal — answer to "knee motor at the hip chassis vs sim at the knee" The placement difference IS exactly representable for a rigid belt. The rotor spins at θm = (qkn + c·qhp)/G, so its full joint-space inertia block is (Ir/G²)·[[c², c],[c, 1]]: the diagonals are the cfg armature entries, and the off-diagonal c·Ir/G² = 26.4e-3 is implementable as a plant force — BeltKneeDCMotor.rotor_coupling=True now applies τhp −= mx·q̈kn (and vice versa) post-clip, with mx = c·armaturekn so it scales with the per-env DR draw. On the 08-13 fall logs (data/_p7_offdiag_phantom.py, 28 leg-windows) this missing torque has rms equal to the hip's own commands (median ratio 0.96), peaks ~5 Nm (p90 7.6), and in the traces it peaks at t = 0.16–0.20 s — the measured fall-initiation window (0.161 s ± 15 ms, pitch-first). It requires simultaneous two-joint acceleration, which is why every single-joint bench test was structurally blind to it — matching the survivor profile the hypothesis board predicted ("something no single-joint bench test excites"). Pre-P7 the term was believed to be 5.7e-3 (ignorable); the rotor re-measurement multiplied it by 4.6.

### Everything else written in P7

- Frictions, joint-space, both factories (runbook: the legacy factory feeds the Phase 8 A/B): Cs 0.146/0.177/0.187, Ck 0.144/0.170/0.185, b 0.043/0.030/0.003 (hp/knee/roll; knee ×1.364 / ×1.860 belt reflections). Centers moved onto the measured values — the ×0.5–2 bands now contain reality by construction.
- act_lag_enable=False (P4 verdict); the four dr_act_lag_*_mult bounds pinned at 1.0 so priv-obs dims [61:73] stay allocated as constants — no critic renumbering, no env-code edits.
- dr_joint_delay 2 → 1 (M1.2: skew 1.96 ms = 0.2 tick); action 1/2 and IMU 1/1 unchanged per the review.
- dr_mass_mult → [0.94, 1.18] (P6 weigh-in).
- sysid_replay_policy_log.py no longer pins the old armature defaults — factory defaults rule unless --hip_armature given.
- Smoke test (_env_smoke_belt.py, 8 envs, 25 steps): boots, steps, DR write path alive, act_lag OFF banner confirmed.

## Phase 8 — Replica gate, first pass moved decisively — not yet crossed

Same test as 08-13 (data/_launch_match_sim.py, G2i model_4760, 512 envs, full DR), only the plant changed. On the old plant, hw_matched survived 6 s — that result established the plant gap. On the P7 plant:

Condition | died | p10 | p25 | p50 | <2.0 s | pitch drift @0.35 s
random_phase (sim's own reset) | 512/512 | 0.61 | 0.85 | 2.96 | 46.7% | −0.237, 82% one-signed
phase0 | 512/512 | 0.62 | 0.92 | 2.64 | 47.3% | −0.225, 81%
hw_matched (the hardware launch) | 512/512 | 0.64 | 0.91 | 1.93 | 50.6% | −0.238, 83% one-signed
hw_tilt (pitched start) | 512/512 | 0.81 | 1.21 | 3.59 | 39.5% | −0.058, 68%

Reading: the corrected plant flips hw_matched from indefinite balance to universal, pitch-first falls in the hardware's direction — the gap has closed from "sim can't fall" to "sim falls the right way but slower and with spread" (hardware: deterministic ~0.25 s tip, onset 0.161 s; sim p10 0.64 s, median 1.93 s).

### Residual-timing candidates checked same session

- Recorded obs contract (−0.089 trim over-correction): does not close it. Compound run with --pg-bias -0.112 (the launch reading the policy actually saw): hw_matched p10 0.59 / p25 0.83 / median 2.99 s, <2 s 47.7% — early quantiles shift ~0.06 s earlier, no collapse toward the hardware cluster. (random_phase does degrade, 2.96 → 1.72 s median, so the bias hurts — it's just not the discriminator.)
- Stale knee REAL_KP=16: never flew — candidate dead. The fall logs record sim-space kp [6,8,8] per tick, and motor_bridge._sim_to_motor_gains applies the G² transform (kp_m = 8·(22/30)² ≈ 4.3 to the knee motor). The Phase 10 audit item "recompute knee REAL_KP" targets a latent config constant, not the flown contract. Contract clean.
- Latency (operator hypothesis: “maybe the shorter latency now”): does not move it. Gate rerun with all delay taps forced to hardware truth (--action-delay 0,0 --joint-delay 0,0): hw_matched p10 0.63 / p25 0.80 / median 3.03 s — statistically the same distribution as the 1-tick run. The residual is not a delay artifact in either direction.
- Still open for the residual: (a) per-env DR draws vs the ONE real plant — the sim's harsh-draw tail (p10–p25: 0.6–0.9 s) is the right comparison against hardware's ~0.25 s, and the real plant may sit at the harsh corner (the knee bench implies a rotor 40% above the hip's — if both RS01s are at 19e-3 the real plant is harsher than the sim central); (b) the commanded-τ scale degeneracy (a weaker-than-commanded real motor falls faster than the replica) — the knee belt-off run arbitrates; (c) lash small-signal / launch transient, still unmodeled.

Consequence independent of the gate: the G2i policy cannot fly the corrected plant even in its own reset distribution (random_phase: all die, median 2.96 s). Whatever the final gate verdict, Phase 9 must be a fresh retrain — the old checkpoints are policies for a plant that does not exist.

## Tooling shipped today

Script | Does
control/robstride_param_read.py | +SocketCAN transport, +0x7021 filter registers, +guarded RAM write, per-motor host-id fallback
control/vel_decode_check.py | P0 spin test; integral-fit verdict (jitter-immune)
control/action_latency_bench.py | M1.1 τ-step onset; PD-hold baseline, travel guard, detrended quadratic fit
control/imu_enc_skew_log.py | M1.2 arrival-skew logger; also yields the fw velocity-filter lag
control/kd_filter_chirp.py + data/kd_chirp_fit.py | M2.1 FRF ladder + synthetic-validated fit
control/kd_brake_test.py | M2.1 decisive brake-decay discriminator
control/pos_step_test.py | M2.3 kp-only step test
control/ballistic_torque_probe.py | M3.1 torque ceiling from τ bursts vs known inertia — no load rig, self-calibrating
data/step_lag_fit.py | M4.1 single-kp step fit + model-free ring/droop metrics; synthetic-validated
data/kp_sweep_fit.py | M4.1 kp-triplet joint fit, model comparison rigid vs fb-filter vs fb-delay (fractional-delay, differentiable); synthetic-validated
control/friction_breakaway.py | P5 commanded-τ breakaway ramp; gravity cancels by direction symmetry; offline --analyze re-threshold
control/coast_down_bench.py | P5 capture, three modes; ballistic (default) = M3.1 envelope with offset-start reps, stall guard, logged brake
data/coastdown_fit.py | P5 burst-primary fit (I/C/b/gravity) + PD-brake reconstruction; 8 synthetic selftest cases incl. lash + b/g1 degeneracy

Raw data: data/*.npz (lat_/skew_/kdchirp_/kdbrake_/step_ + vel_check_), duplicated on the Pi. All scripts synced both ways through origin/main.

Master gate — status after P8 first pass The gate asked for a replica that tips forward pitch-first in <0.5 s with onset near 0.16 s. The P7 plant delivers the mechanism and the direction: hw_matched went from surviving 6 s to 512/512 pitch-first falls (83% one-signed, hardware's sign), with the missing rotor coupling identified, measured, and peaking at the observed 0.161 s onset in fall-log replay. The timing distribution (p10 0.64 s, median 1.93 s across DR draws) is not yet the hardware's deterministic ~0.25 s cluster; obs-contract bias and the stale-REAL_KP candidates for that residual are eliminated, DR-draw spread and the commanded-τ scale remain. Retrain justification no longer rests on the gate alone: the flying policy cannot balance the measured plant in any launch condition.
