jiz322/tiptoe-biped/analysis_motor_filters/chirp_tf_sysid_leg1_20260621_121723_kn_float_chirp.png

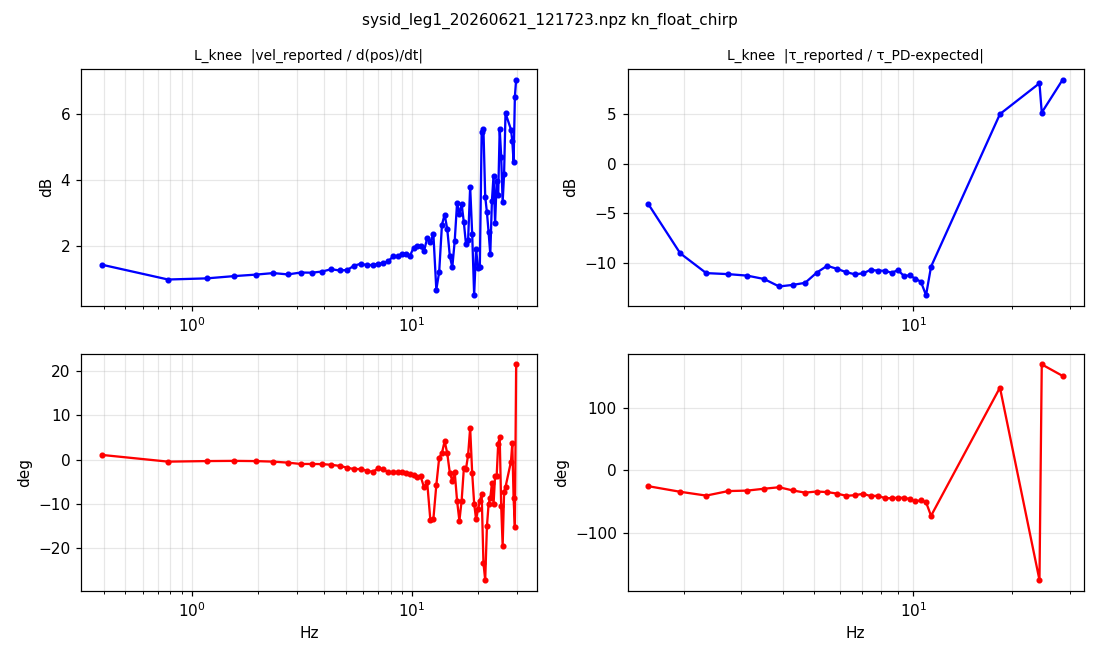
analysis_motor_filters/chirp_tf_sysid_leg1_20260621_121723_kn_float_chirp.png
