jiz322/tiptoe-biped/data/flight_20261014/figs/standup_vs_1011.png

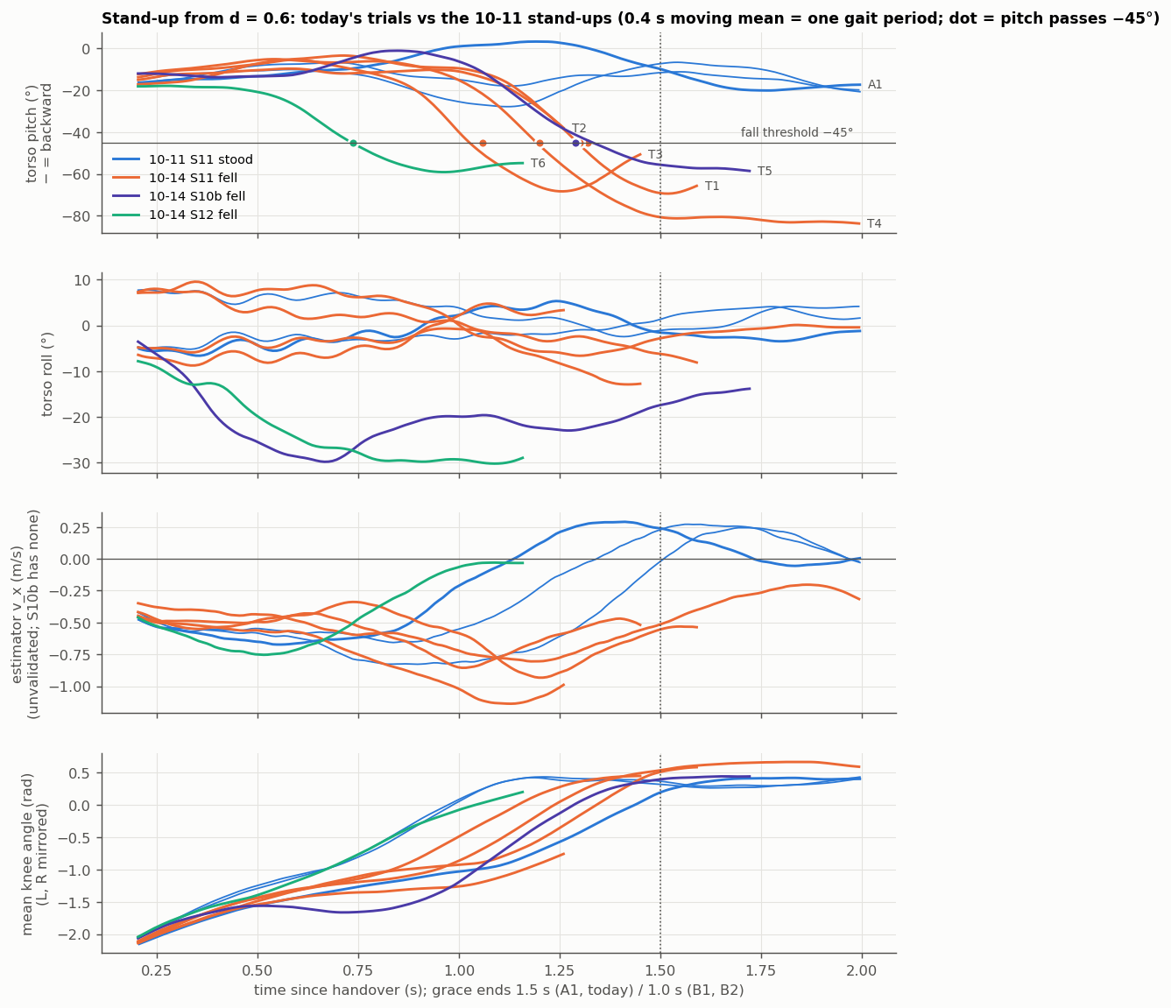
data/flight_20261014/figs/standup_vs_1011.png
