jiz322/tiptoe-biped/data/s11_flight_20261011/figs/b1_joints.png

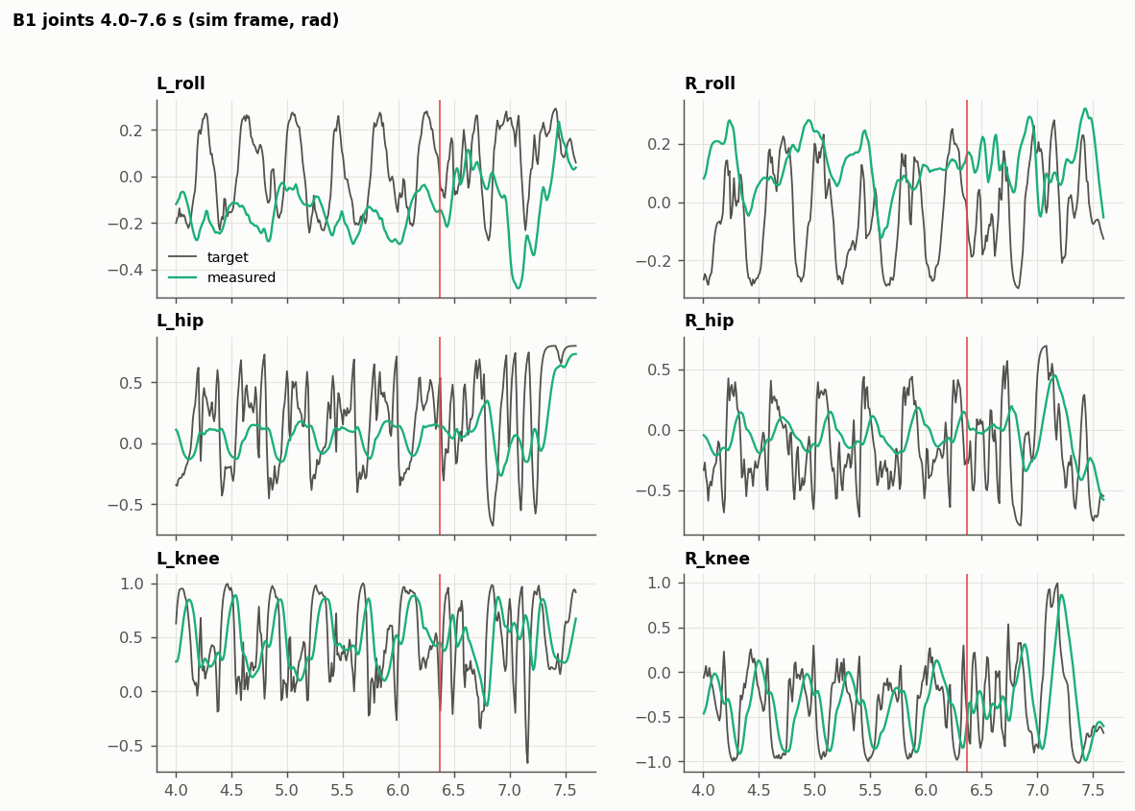
data/s11_flight_20261011/figs/b1_joints.png
