jiz322/tiptoe-biped/data/s11_flight_20261011/figs/overview_A1.png

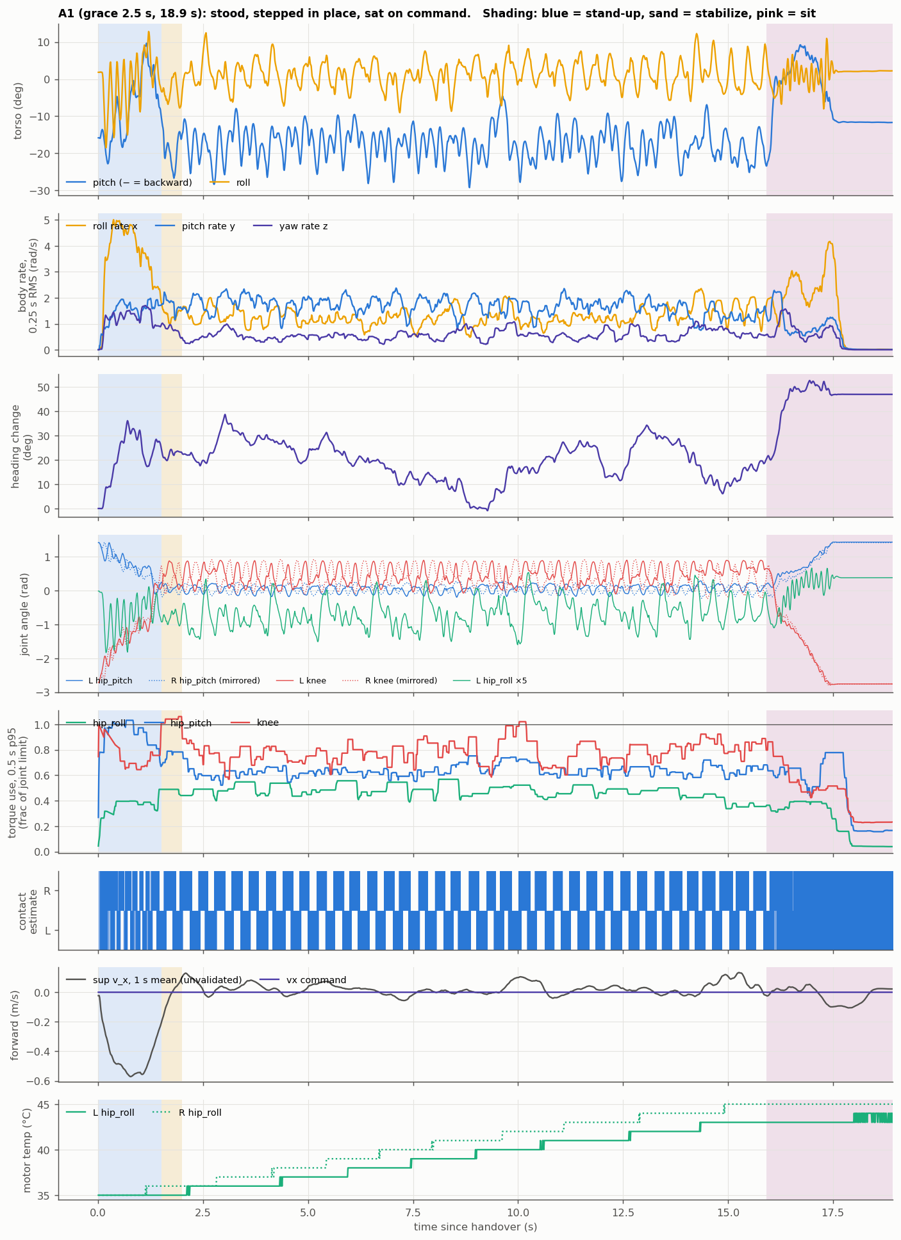
data/s11_flight_20261011/figs/overview_A1.png
