jiz322/tiptoe-biped/data/s11_flight_20261011/figs/overview_B1.png

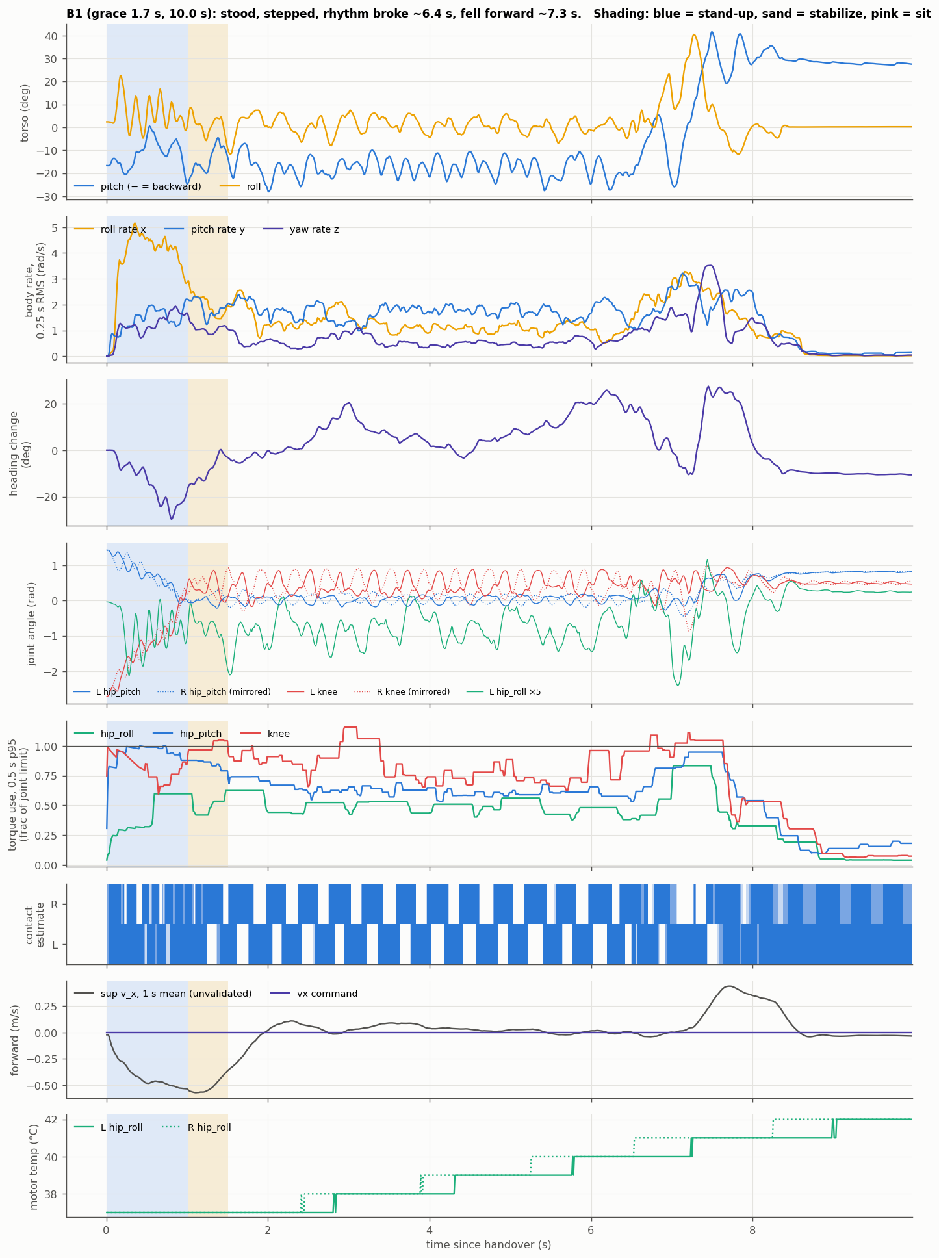
data/s11_flight_20261011/figs/overview_B1.png
