jiz322/tiptoe-biped/assets/tiptoe_v27/meshes/simplified_pulley30.stl

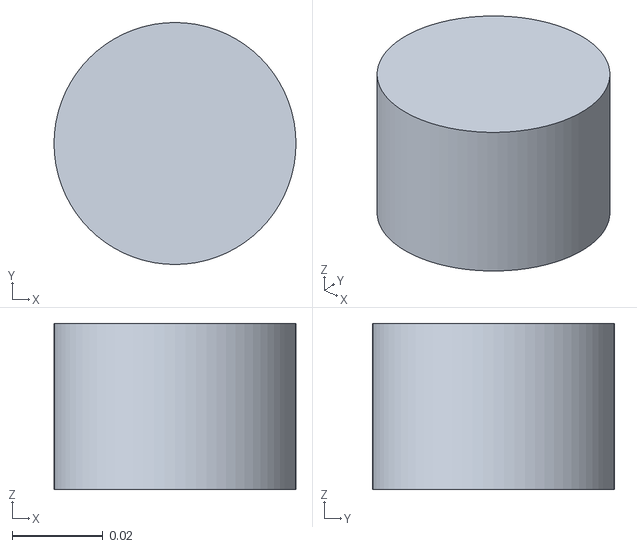
[picture p46: CAD file, 2026-09-24]
assets/tiptoe_v27/meshes/simplified_pulley30.stl
0.0534 x 0.0534 x 0.0367
