jiz322/tiptoe-biped/assets/tiptoe_v27/meshes/stand_steel_00.stl

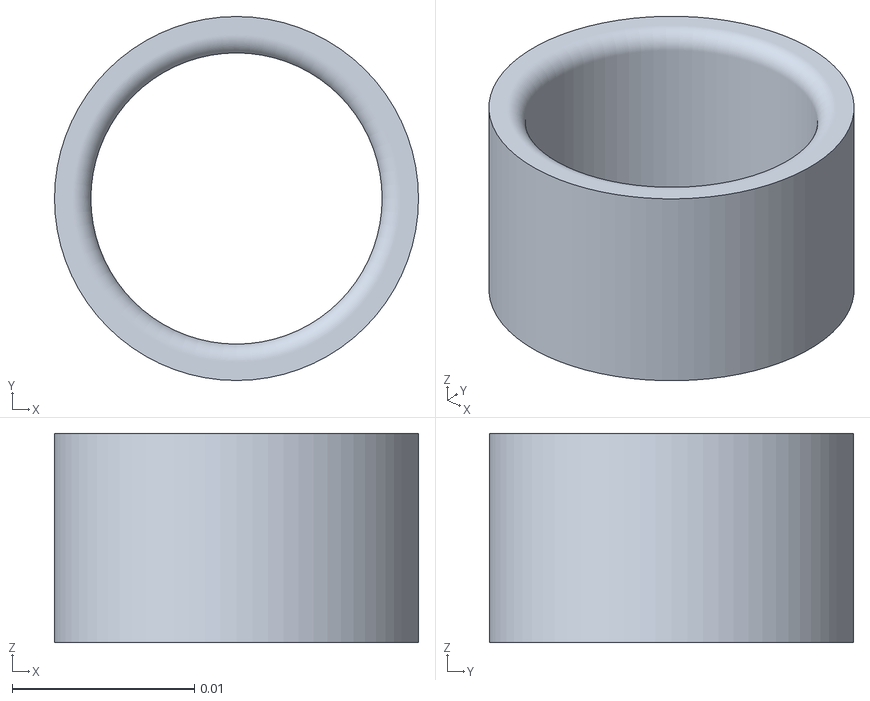
[picture p47: CAD file, 2026-09-24]
assets/tiptoe_v27/meshes/stand_steel_00.stl
0.02 x 0.02 x 0.0115
