jiz322/tiptoe-biped/assets/tiptoe_v27/meshes/lid_bearing_inner.stl

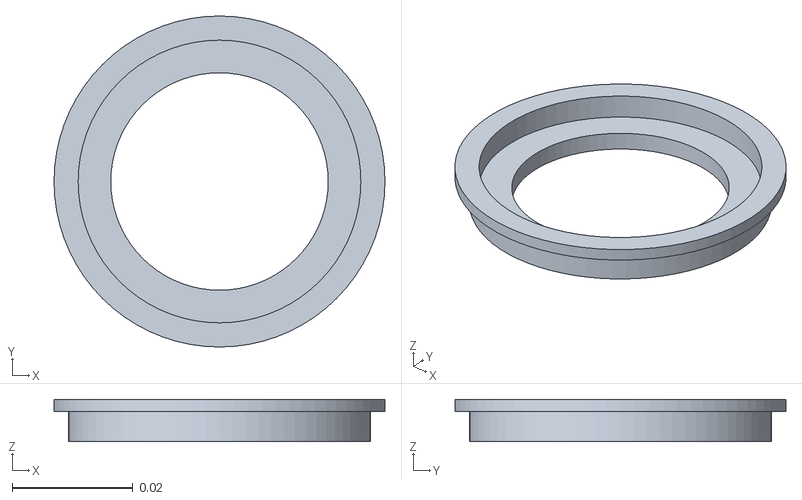
[picture p48: CAD file, 2026-09-24]
assets/tiptoe_v27/meshes/lid_bearing_inner.stl
0.0548 x 0.0548 x 0.007
