jiz322/tiptoe-biped/assets/tiptoe_v27/meshes/motor01_simplified.stl

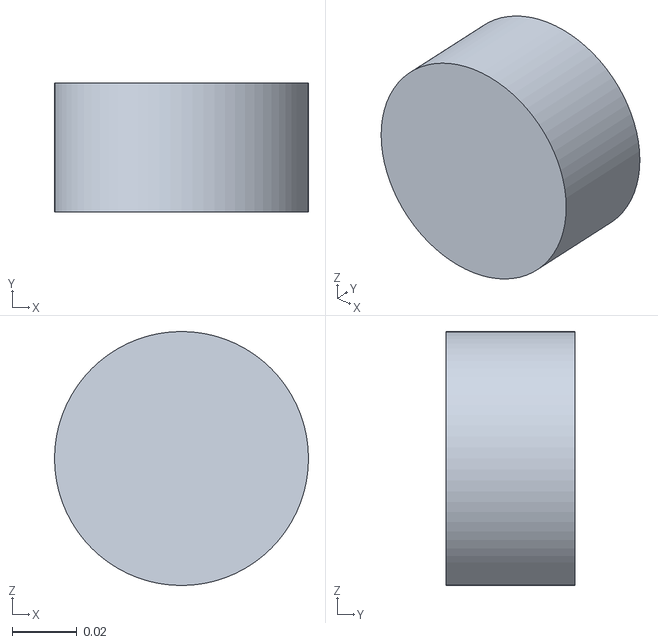
[picture p49: CAD file, 2026-09-24]
assets/tiptoe_v27/meshes/motor01_simplified.stl
0.0785 x 0.04 x 0.0785
