jiz322/tiptoe-biped/assets/tiptoe_v27/meshes/knee_steel.stl

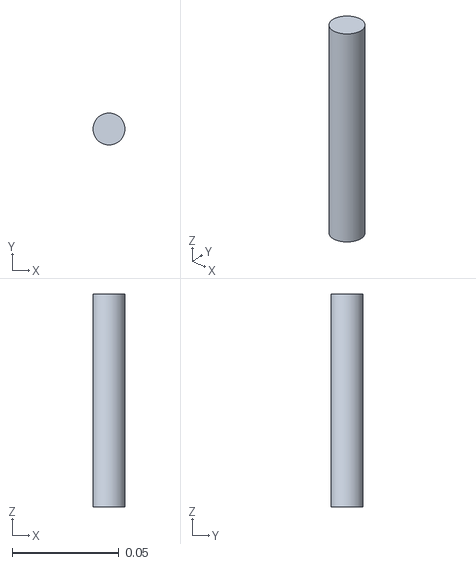
[picture p50: CAD file, 2026-09-24]
assets/tiptoe_v27/meshes/knee_steel.stl
0.015 x 0.015 x 0.1
