jiz322/tiptoe-biped/assets/tiptoe_v27/meshes/nail___fillet1.stl

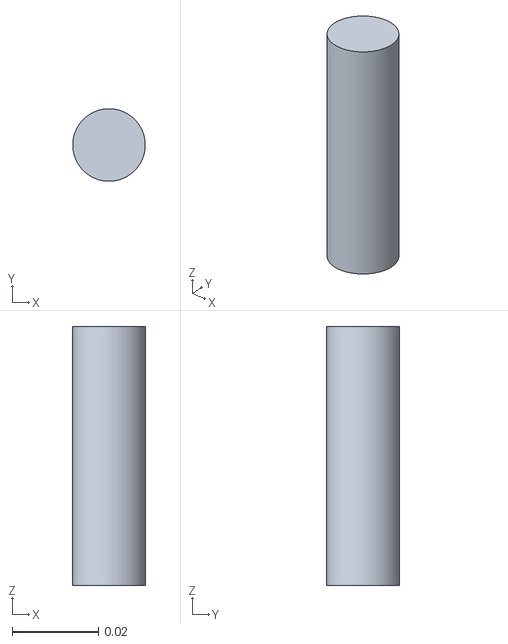
[picture p52: CAD file, 2026-09-24]
assets/tiptoe_v27/meshes/nail___fillet1.stl
0.0168 x 0.0168 x 0.06
