jiz322/tiptoe-biped/assets/tiptoe_v27/meshes/v2_thighlid_passive_inner2___boss_extrude2.stl

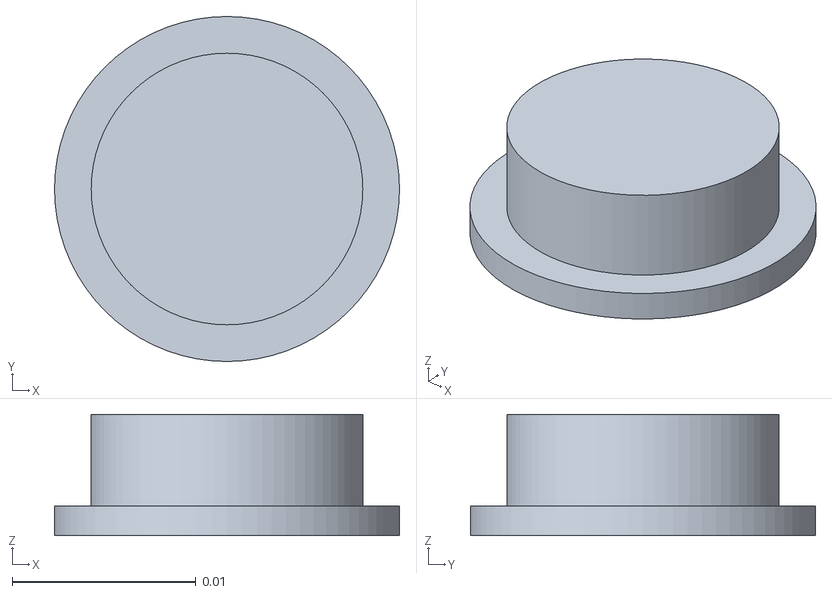
[picture p53: CAD file, 2026-09-24]
assets/tiptoe_v27/meshes/v2_thighlid_passive_inner2___boss_extrude2.stl
0.0188 x 0.0188 x 0.0066
