jiz322/tiptoe-biped/assets/tiptoe_v27/meshes/chasis_motor2motor___mirror1.stl

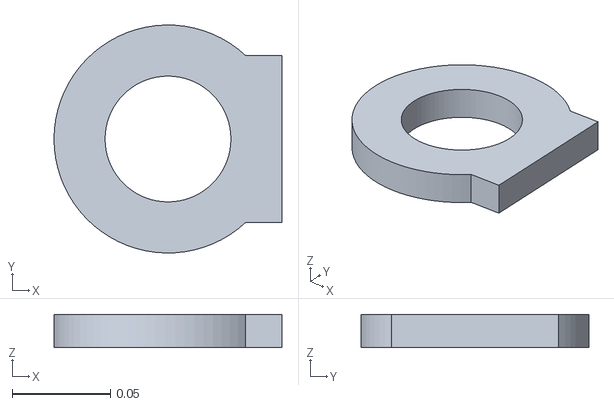
[picture p54: CAD file, 2026-09-24]
assets/tiptoe_v27/meshes/chasis_motor2motor___mirror1.stl
0.116 x 0.116 x 0.017
