jiz322/tiptoe-biped/assets/tiptoe_v27/meshes/el05_flang.stl

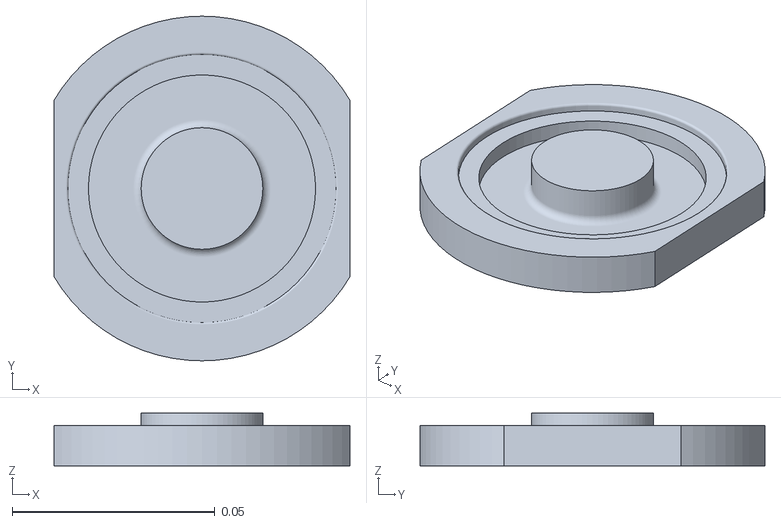
[picture p55: CAD file, 2026-09-24]
assets/tiptoe_v27/meshes/el05_flang.stl
0.073 x 0.085 x 0.013
