jiz322/tiptoe-biped/assets/tiptoe_v27/meshes/shin_outer.stl

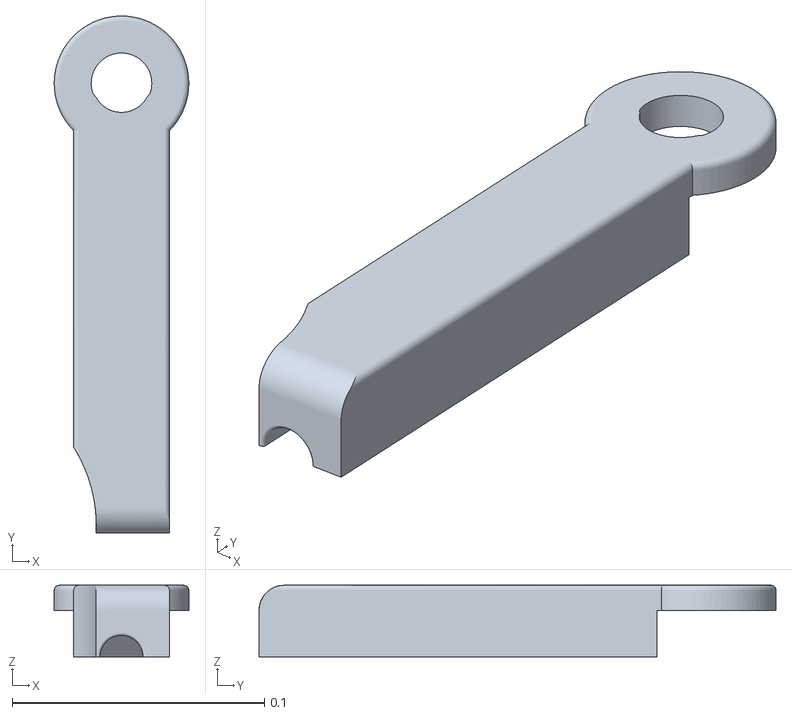
[picture p56: CAD file, 2026-09-24]
assets/tiptoe_v27/meshes/shin_outer.stl
0.0534 x 0.205 x 0.0283
