jiz322/tiptoe-biped/assets/tiptoe_v27/meshes/thigh_inner.stl

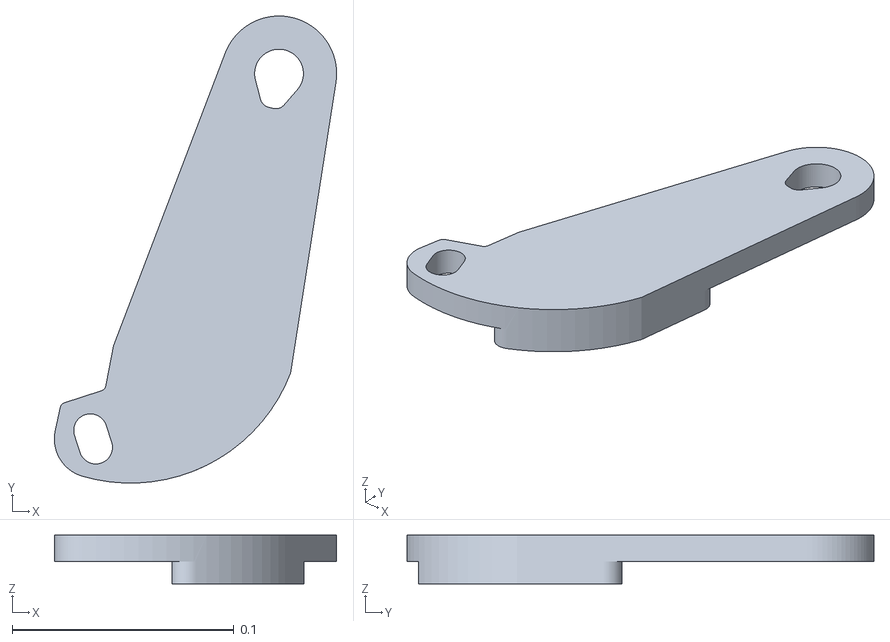
[picture p57: CAD file, 2026-09-24]
assets/tiptoe_v27/meshes/thigh_inner.stl
0.127 x 0.211 x 0.022
