jiz322/tiptoe-biped/assets/tiptoe_v27/meshes/battery.stl

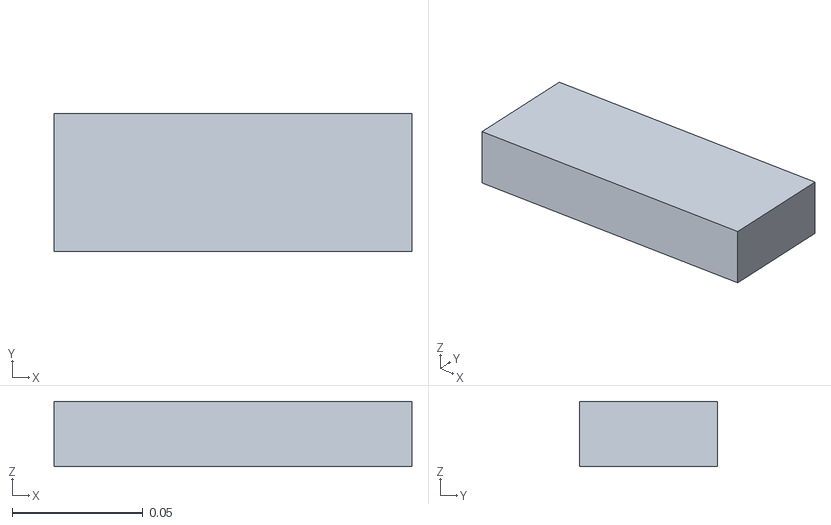
[picture p58: CAD file, 2026-09-24]
assets/tiptoe_v27/meshes/battery.stl
0.137 x 0.053 x 0.025
