jiz322/tiptoe-biped/assets/tiptoe_v27/meshes/v2_thighlid_passive_outer.stl

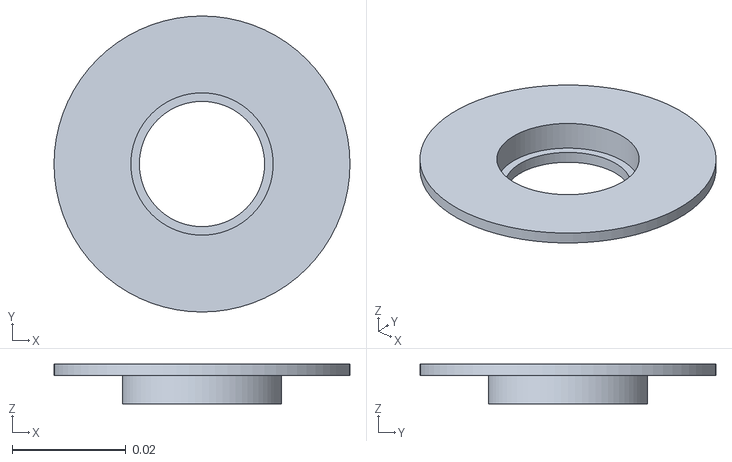
[picture p59: CAD file, 2026-09-24]
assets/tiptoe_v27/meshes/v2_thighlid_passive_outer.stl
0.052 x 0.052 x 0.007
