jiz322/tiptoe-biped/assets/tiptoe_v27/meshes/torso2hip.stl

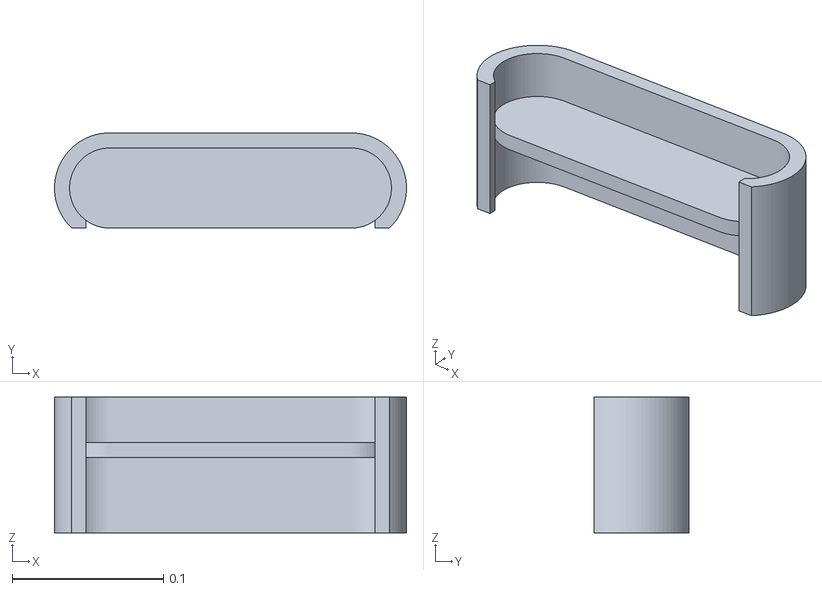
[picture p60: CAD file, 2026-09-24]
assets/tiptoe_v27/meshes/torso2hip.stl
0.233 x 0.063 x 0.09
