jiz322/tiptoe-biped/assets/tiptoe_v27/meshes/thigh_outer___cut_extrude4.stl

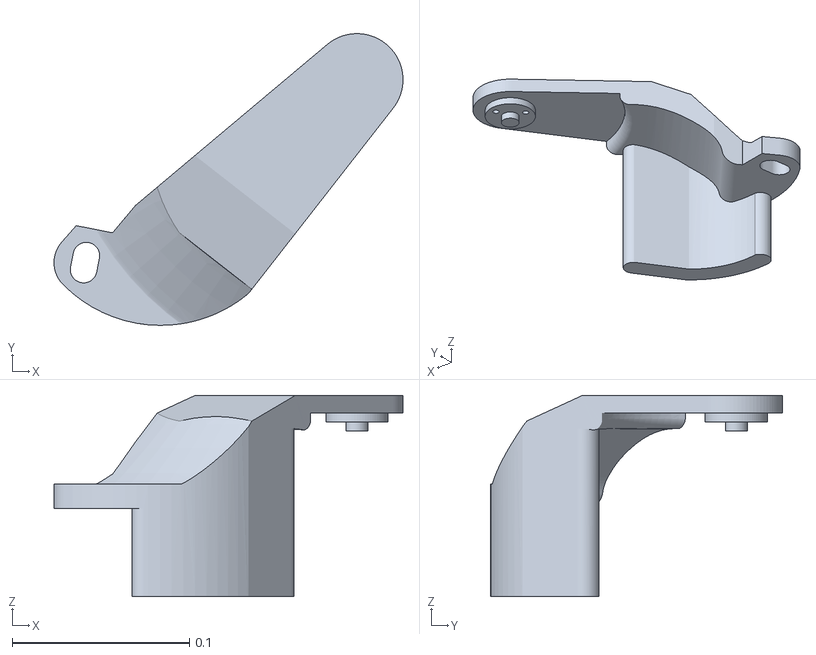
[picture p61: CAD file, 2026-09-24]
assets/tiptoe_v27/meshes/thigh_outer___cut_extrude4.stl
0.197 x 0.165 x 0.113
