jiz322/tiptoe-biped/assets/tiptoe_v27/meshes/lid_bearing_outer.stl

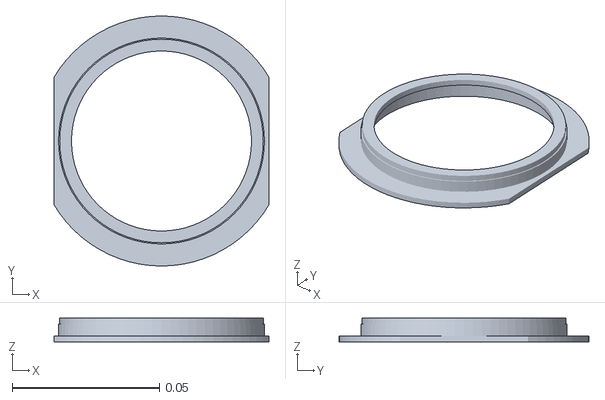
[picture p62: CAD file, 2026-09-24]
assets/tiptoe_v27/meshes/lid_bearing_outer.stl
0.073 x 0.085 x 0.008
