jiz322/tiptoe-biped/assets/tiptoe_v27/meshes/part_3.stl

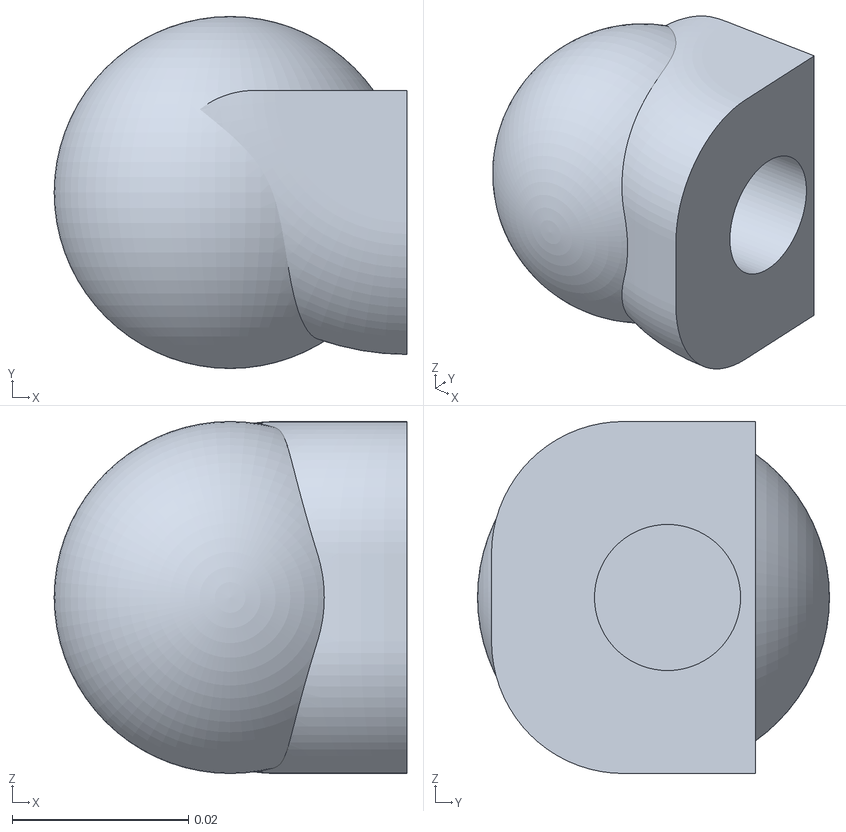
[picture p63: CAD file, 2026-09-24]
assets/tiptoe_v27/meshes/part_3.stl
0.0401 x 0.04 x 0.04
