jiz322/tiptoe-biped/assets/tiptoe_v27/meshes/chasis_side___boss_extrude1.stl

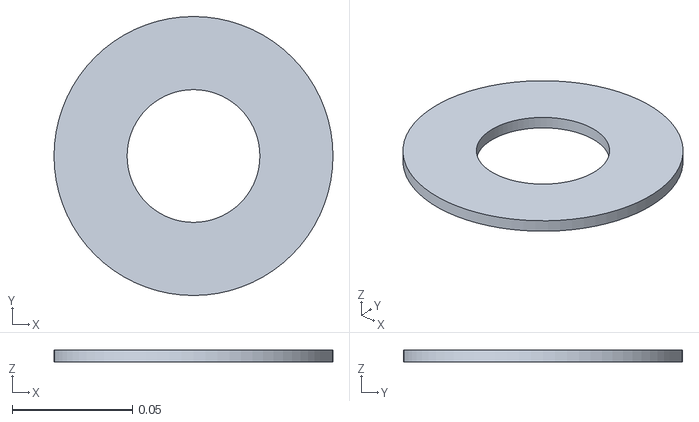
[picture p64: CAD file, 2026-09-24]
assets/tiptoe_v27/meshes/chasis_side___boss_extrude1.stl
0.116 x 0.116 x 0.005
