jiz322/tiptoe-biped/assets/tiptoe_v27/meshes/chasis_rotate_00.stl

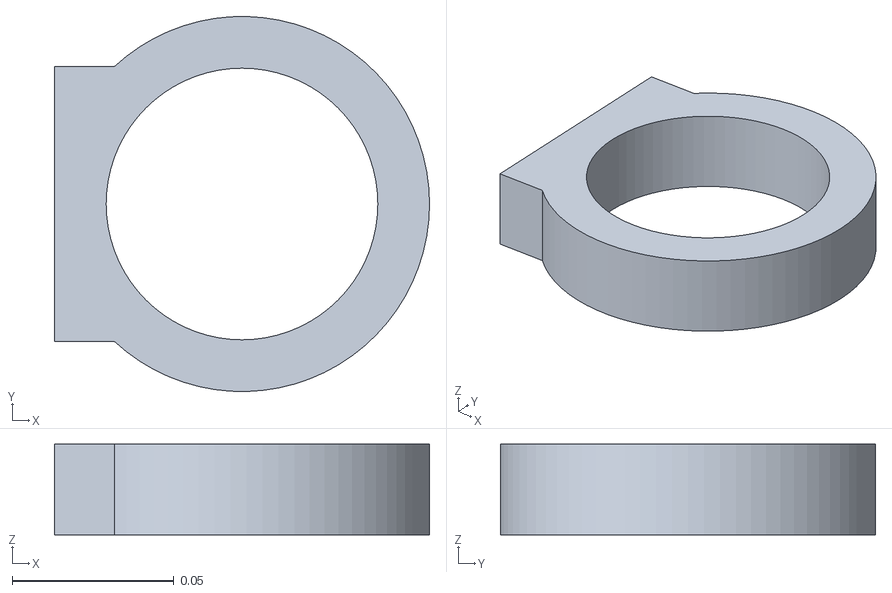
[picture p65: CAD file, 2026-09-24]
assets/tiptoe_v27/meshes/chasis_rotate_00.stl
0.116 x 0.116 x 0.028
