jiz322/tiptoe-biped/assets/tiptoe_v27/meshes/v2_thighlid_passive_inner___m4_clearance_hole1.stl

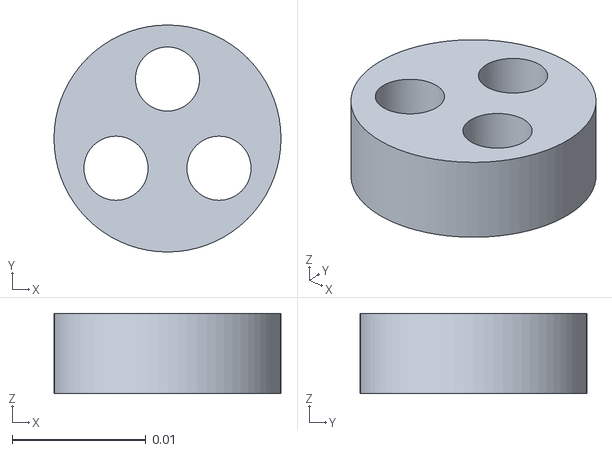
[picture p66: CAD file, 2026-09-24]
assets/tiptoe_v27/meshes/v2_thighlid_passive_inner___m4_clearance_hole1.stl
0.017 x 0.017 x 0.006
