jiz322/tiptoe-biped/assets/tiptoe_v27/meshes/simplified_pulley22.stl

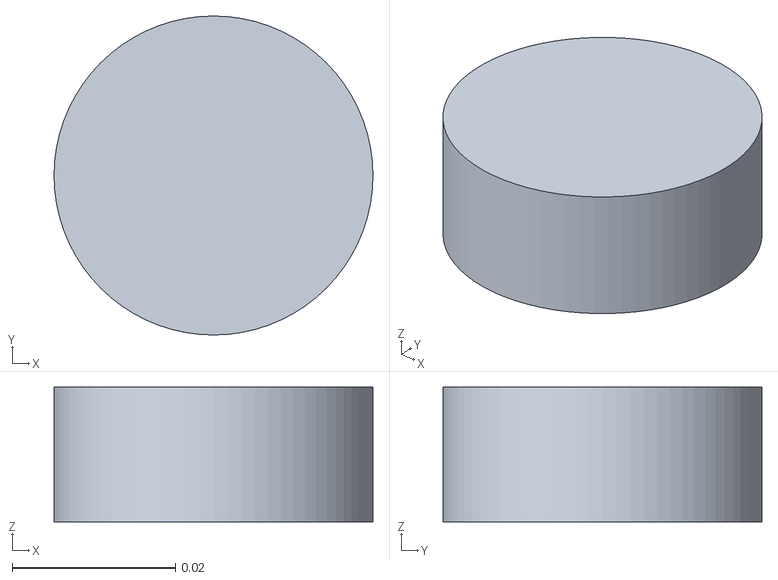
[picture p67: CAD file, 2026-09-24]
assets/tiptoe_v27/meshes/simplified_pulley22.stl
0.0391 x 0.0391 x 0.0165
