jiz322/tiptoe-biped/assets/tiptoe_v27/meshes/torso_top_board.stl

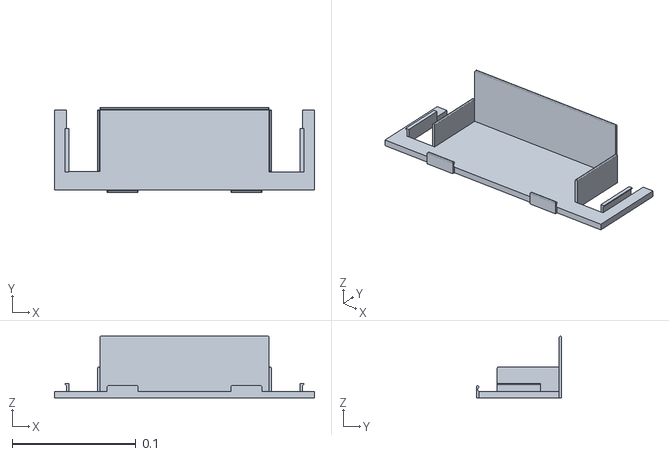
[picture p68: CAD file, 2026-09-24]
assets/tiptoe_v27/meshes/torso_top_board.stl
0.21 x 0.069 x 0.05
