jiz322/tiptoe-biped/assets/tiptoe_v27/meshes/motor05_simplified.stl

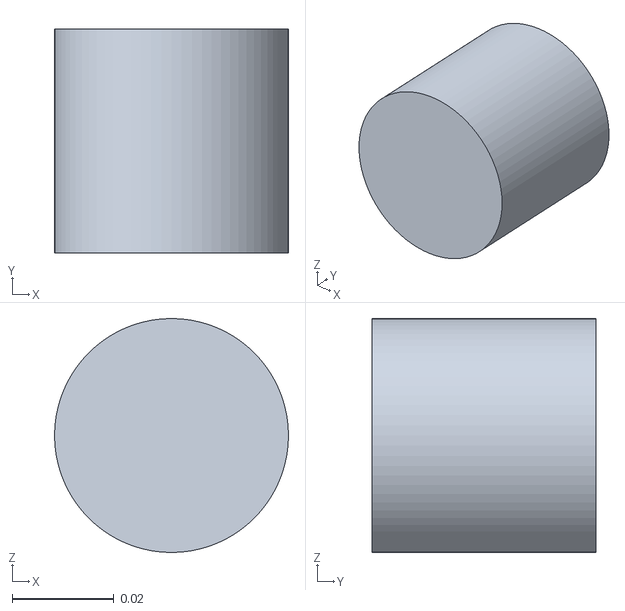
[picture p69: CAD file, 2026-09-24]
assets/tiptoe_v27/meshes/motor05_simplified.stl
0.046 x 0.044 x 0.046
