jiz322/tiptoe-biped/(list of files, cad)

Other CAD files:
assets/tiptoe_v27/meshes/stand_steel_00___fillet1.stl
assets/tiptoe_v27/meshes/shin_inner___fillet12.stl
assets/tiptoe_v27/meshes/chasis_motor2motor.stl
assets/tiptoe_v27/meshes/knee_steel___boss_extrude1.stl
assets/tiptoe_v27/meshes/lid_bearing_inner___boss_extrude3.stl
assets/tiptoe_v27/meshes/el05_flang___fillet3.stl
assets/tiptoe_v27/meshes/shin_outer___fillet13.stl
assets/tiptoe_v27/meshes/nail.stl
assets/tiptoe_v27/meshes/v2_thighlid_passive_inner2.stl
assets/tiptoe_v27/meshes/chasis_rotate_00___fillet1.stl
assets/tiptoe_v27/meshes/thigh_outer.stl
assets/tiptoe_v27/meshes/chasis_side.stl
assets/tiptoe_v27/meshes/lid_bearing_outer___boss_extrude3.stl
assets/tiptoe_v27/meshes/v2_thighlid_passive_outer___boss_extrude3.stl
assets/tiptoe_v27/meshes/v2_thighlid_passive_inner.stl
assets/tiptoe_v27/meshes/thigh_inner___fillet4.stl
