jiz322/tiptoe-biped/analysis_motor_filters/step_sysid_leg1_20260621_121723_kn_stiff_step_-0.6.png

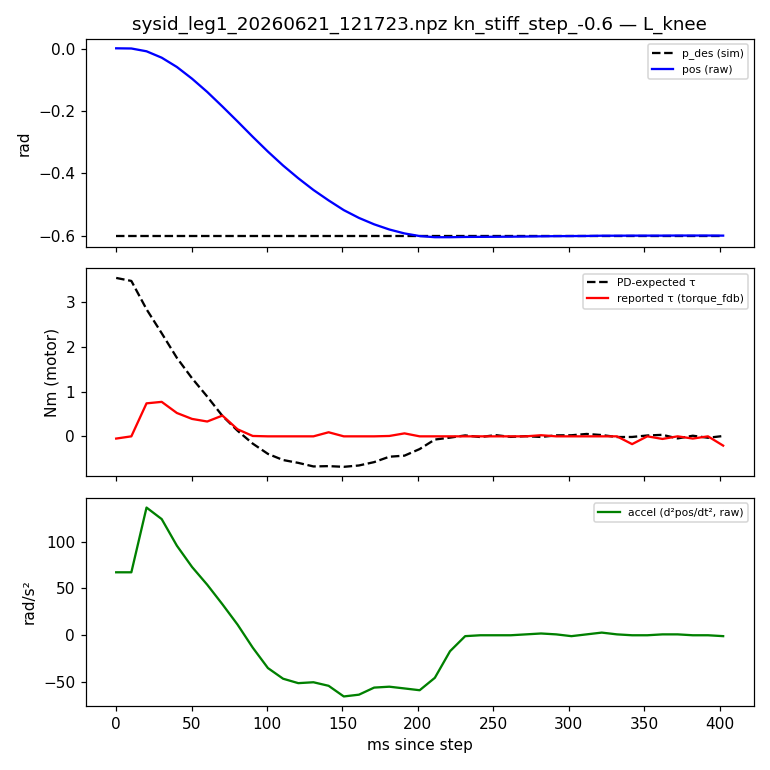
analysis_motor_filters/step_sysid_leg1_20260621_121723_kn_stiff_step_-0.6.png
