jiz322/tiptoe-biped/analysis_motor_filters/step_sysid_leg1_20260622_122841_hp_step_-0.6.png

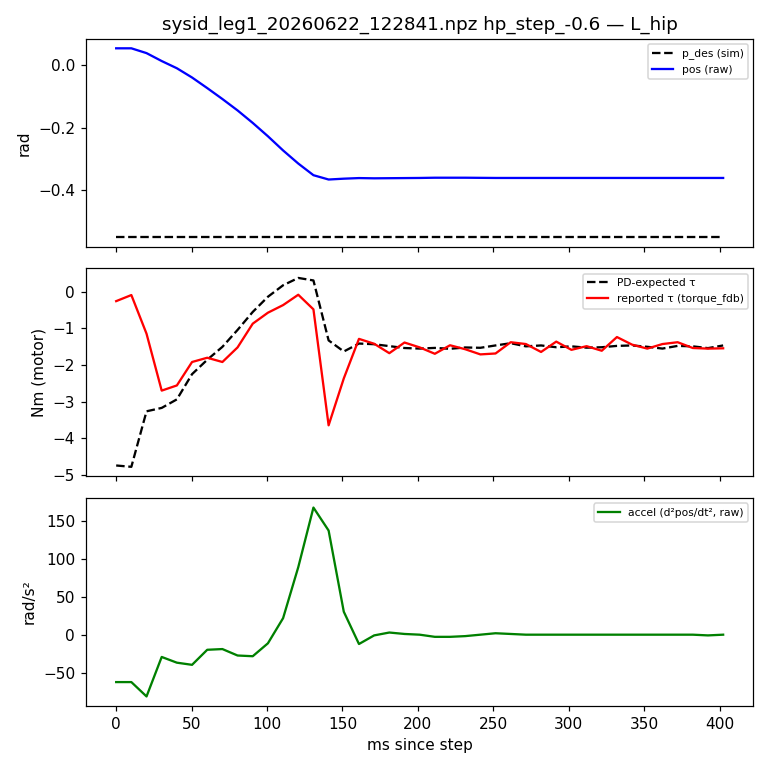
analysis_motor_filters/step_sysid_leg1_20260622_122841_hp_step_-0.6.png
