jiz322/tiptoe-biped/analysis_motor_filters/results_part2.txt

=== sysid_leg1_20260621_121723.npz ===

  [1] STEP PLATEAU (last 0.5 s) — DC telemetry scale, filter-free
      trial                   err_inf   τ_exp  τ_meas  ratio
      hr_step_+0.2              0.063    0.38    0.40   1.05
      hr_step_-0.2             -0.025   -0.15   -0.17    nan
      hr_step_+0.4              0.093    0.56    0.59   1.06
      hr_step_-0.4             -0.048   -0.28   -0.32   1.14
      hp_step_+0.3              0.051    0.45    0.46   1.03
      hp_step_-0.3              0.014    0.11    0.22    nan
      hp_step_-0.6              0.002    0.04   -0.00    nan
      kn_stiff_step_+0.3       -0.006   -0.03   -0.14    nan
      kn_stiff_step_-0.3        0.004    0.03   -0.00    nan
      kn_stiff_step_+0.6       -0.003   -0.01   -0.01    nan
      kn_stiff_step_-0.6       -0.001    0.00   -0.00    nan
      kn_float_step_+0.3        0.006    0.02   -0.00    nan
      kn_float_step_-0.3        0.010    0.05    0.12    nan

  [2] STEP ONSET (ticks 1-3 from rest) — expected = kp_m·err, filter shows as ramp
      trial                   τ_exp@1  meas@1  meas@2  meas@3  meas@5
      hr_step_+0.2               1.36    0.12    0.36    0.49    0.75
      hr_step_-0.2              -1.11   -0.08    0.12    0.48    0.76
      hr_step_+0.4               2.59    0.08    0.30    0.45    0.69
      hr_step_-0.4              -2.32   -0.03    0.10    0.43    0.65
      hp_step_+0.3               2.51    0.13    0.64    0.80    0.92
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
      kn_stiff_step_+0.6        -3.51    0.00    0.34    0.33    0.22
      kn_stiff_step_-0.6         3.54   -0.00    0.38    0.36    0.24
      kn_float_step_+0.3        -1.73    0.00    0.26    0.49    0.60
      kn_float_step_-0.3         1.75   -0.00    0.24    0.22    0.45

  [3] CV PLATEAUS — quasi-static τ_meas vs τ_exp (scale a, offset b)
      trial              v_tgt  |v|med      a      b    n
      hr_tri_0            0.50    0.43   1.01   0.00  239
      hr_tri_2            2.00    1.34   0.69   0.03   52
      hp_tri_0            0.50    0.48   1.31  -0.06  120
      hp_tri_2            2.00    2.14   1.30  -0.02  117

  [4] VEL INTEGRAL — sum(vel·dt) / Δpos per excited motor (DC gain of vel channel)
      L_roll   ∫|vel|dt / Σ|Δpos| = 1.028  (IQR 0.995-1.052, n=5)
      L_hip    ∫|vel|dt / Σ|Δpos| = 1.143  (IQR 1.122-1.205, n=4)
      L_knee   ∫|vel|dt / Σ|Δpos| = 1.151  (IQR 1.126-1.216, n=7)

  [5] CHIRP BAND-SPLIT — torque scale (LS) in low vs high band
      hr_chirp           0.5-1.5Hz  scale= 0.61
      hr_chirp               4-8Hz  scale= 0.33
      hp_chirp           0.5-1.5Hz  scale= 0.53
      hp_chirp               4-8Hz  scale= 0.64
      kn_stiff_chirp     0.5-1.5Hz  scale= 0.28
      kn_stiff_chirp         4-8Hz  scale= 0.21
      kn_float_chirp     0.5-1.5Hz  scale= 0.22
      kn_float_chirp         4-8Hz  scale= 0.22

=== BALANCE RUN CONFIGS [G2i] ===
  file                                       ticks   kp (hr/hp/kn)            kd      tau_max  lpf  drop%
  policy_G2i4760_log_20260813_124157.npz       209   6.0/ 8.0/ 8.0  0.3/0.5/0.5    6/ 17/ 17  0.6    0.0
  policy_G2i4760_log_20260813_124253.npz       215   6.0/ 8.0/ 8.0  0.3/0.5/0.5    6/ 17/ 17  0.6    0.0
  policy_G2i4760_log_20260813_124332.npz       373   6.0/ 8.0/ 8.0  0.3/0.5/0.5    6/ 17/ 17  0.6    0.0
  policy_G2i4760_log_20260813_124401.npz       231   6.0/ 8.0/ 8.0  0.3/0.5/0.5    6/ 17/ 17  0.6    0.0
  policy_G2i4760_log_20260813_124420.npz       185   6.0/ 8.0/ 8.0  0.3/0.5/0.5    6/ 17/ 17  0.6    5.4
  policy_G2i4760_log_20260813_124437.npz       196   6.0/ 8.0/ 8.0  0.3/0.5/0.5    6/ 17/ 17  0.6    2.0
  policy_G2i4760_log_20260813_124453.npz       194   6.0/ 8.0/ 8.0  0.3/0.5/0.5    6/ 17/ 17  0.6    3.1
  policy_G2i4760_log_20260813_124536.npz       156   6.0/ 8.0/ 8.0  0.3/0.5/0.5    6/ 17/ 17  0.6    0.0
  policy_G2i4760_log_20260813_124557.npz       149   6.0/ 8.0/ 8.0  0.3/0.5/0.5    6/ 17/ 17  0.6    0.7
  policy_G2i4760_log_20260813_124636.npz       157   6.0/ 8.0/ 8.0  0.3/0.5/0.5    6/ 17/ 17  0.6    0.0
  policy_G2i4760_log_20260813_124653.npz       212   6.0/ 8.0/ 8.0  0.3/0.5/0.5    6/ 17/ 17  0.6    4.2
  policy_G2i4760_log_20260813_124721.npz       158   6.0/ 8.0/ 8.0  0.3/0.5/0.5    6/ 17/ 17  0.6    8.2
  policy_G2i4760_log_20260813_124738.npz       235   6.0/ 8.0/ 8.0  0.3/0.5/0.5    6/ 17/ 17  0.6   37.0
  policy_G2i4760_log_20260813_124832.npz       293   6.0/ 8.0/ 8.0  0.3/0.5/0.5    6/ 17/ 17  0.6   33.1
  policy_G2i4760_log_20260813_215227.npz       232   6.0/ 8.0/ 8.0  0.3/0.5/0.5    6/ 17/ 17  0.6    1.7
  policy_G2i4760_log_20260813_215404.npz       160   6.0/ 8.0/ 8.0  0.3/0.5/0.5    6/ 17/ 17  0.6   30.0
  policy_G2i4760_log_20260813_215851.npz       119   6.0/ 8.0/ 8.0  0.3/0.5/0.5    6/ 17/ 17  0.6    0.0
  policy_G2i4760_log_20260813_215939.npz       113   6.0/ 8.0/ 8.0  0.3/0.5/0.5    6/ 17/ 17  0.6    7.1
  policy_G2i4760_log_20260813_215950.npz       187   6.0/ 8.0/ 8.0  0.3/0.5/0.5    6/ 17/ 17  0.6    0.0
  policy_G2i4760_log_20260813_220015.npz       125   6.0/ 8.0/ 8.0  0.3/0.5/0.5    6/ 17/ 17  0.6    1.6
  policy_G2i4760_log_20260813_220031.npz       136   6.0/ 8.0/ 8.0  0.3/0.5/0.5    6/ 17/ 17  0.6    4.4
  policy_G2i4760_log_20260813_220157.npz       115   6.0/ 8.0/ 8.0  0.3/0.5/0.5    6/ 17/ 17  0.6    0.0
  policy_G2i4760_log_20260813_220208.npz       114   6.0/ 8.0/ 8.0  0.3/0.5/0.5    6/ 17/ 17  0.6    0.0
  policy_G2i4760_log_20260813_220220.npz       113   6.0/ 8.0/ 8.0  0.3/0.5/0.5    6/ 17/ 17  0.6    0.0
  policy_G2i4760_log_20260813_220232.npz       108   6.0/ 8.0/ 8.0  0.3/0.5/0.5    6/ 17/ 17  0.6    0.0
  policy_G2i4760_log_20260813_220243.npz       100   6.0/ 8.0/ 8.0  0.3/0.5/0.5    6/ 17/ 17  0.6    5.0

  NEAR-STATIC ratio τ_meas/τ_exp (|motor vel|<0.5 rad/s, |τ_exp|>0.4):
    L_roll   median= 0.82  IQR  0.53- 1.11  n=1260
    L_hip    median= 0.81  IQR  0.47- 1.04  n=570
    L_knee   median= 0.65  IQR  0.25- 0.98  n=329
    R_roll   median= 0.81  IQR  0.44- 1.06  n=1058
    R_hip    median= 0.88  IQR  0.65- 1.03  n=814
    R_knee   median= 0.61  IQR  0.35- 0.93  n=283

=== BALANCE RUN CONFIGS [F] ===
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
    L_hip    median= 0.60  IQR  0.14- 0.94  n=1125
    L_knee   median= 0.46  IQR  0.15- 0.98  n=735
    R_roll   median= 0.79  IQR  0.53- 1.02  n=1671
    R_hip    median= 0.75  IQR  0.37- 1.01  n=1246
    R_knee   median= 0.46  IQR  0.11- 0.93  n=686
