jiz322/tiptoe-biped/analysis_motor_filters/results_part4.txt

=== sysid_leg1_20260621_121723.npz ===

[A/C] fixed-filter scale fits (delta=1):  s per tau
  trial               joint     tau=15ms  tau=20ms  tau=25ms  tau=30ms  tau=40ms     R2@25
  hr_step_+0.2        L_roll        0.88      0.87      0.87      0.86      0.86    -4.61
  hr_step_+0.4        L_roll        0.79      0.79      0.78      0.77      0.76    -2.75
  hr_step_-0.4        L_roll        0.59      0.59      0.58      0.58      0.57    -1.46
  hr_chirp            L_roll        0.57      0.63      0.68      0.73      0.81     0.95
  hr_tri_0            L_roll        1.03      1.04      1.04      1.04      1.05     0.99
  hr_tri_2            L_roll        0.80      0.83      0.86      0.89      0.95     0.91
  hp_step_+0.3        L_hip         0.79      0.78      0.76      0.75      0.73    -2.41
  hp_step_-0.3        L_hip         0.34      0.33      0.32      0.31      0.28    -0.99
  hp_step_+0.6        L_hip         0.61      0.60      0.59      0.58      0.56    -1.31
  hp_chirp            L_hip         0.80      0.84      0.88      0.90      0.94     0.64
  hp_tri_0            L_hip         1.05      1.05      1.05      1.05      1.05     0.64
  hp_tri_2            L_hip         0.91      0.92      0.93      0.94      0.95     0.73
  kn_stiff_chirp      L_knee        0.35      0.37      0.39      0.41      0.46     0.58
  kn_stiff_tri_2      L_knee        0.56      0.58      0.60      0.63      0.67     0.38
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
  hp_tri_2            L_hip        0.17     -0.00    -0.16     -0.00
  kn_stiff_tri_0      L_knee       0.05     -0.00    -0.04     -0.10
  kn_stiff_tri_2      L_knee       0.12     -0.00    -0.09     -0.01
  kn_float_tri_1      L_knee       0.04     -0.00    -0.05     -0.12
