jiz322/tiptoe-biped/control/set_host_ids.py

"""set_host_ids.py — give each motor a DISTINCT MIT reply arbitration id.

Why: in MIT mode every RobStride-protocol motor addresses its feedback
frame to the HOST CAN id (default 0xFD = 253), with the replying motor's
own id in data[0]. All six motors therefore reply on the same
arbitration id, same-id frames cannot arbitrate, and back-to-back
requests collide (runbook Results 2026-08-15: T4 @0 pacing ~0% full,
error-passive 72k). CAN2SPI_PACING_S = 0.5 ms works around it; distinct
per-motor host ids remove the collision domain entirely and license
zero pacing. Full procedure: BASELINE_RUNBOOK.md Phase D.

Mechanism (RobStride MIT protocol, "Command 9 — Modify Host CAN ID"):
    standard frame, arbitration id = motor id,
    data = FF FF FF FF FF FF <new_host_id> 01
Source: RobStride 00 instruction manual (wiki.aifitlab.com mirror),
single-source as of 2026-08-16 — which is why every --set here is
verified empirically (probe reply id before/after) and --revert exists.
Both driver and bench key replies on data[0], never on the arbitration
id, so they work unchanged under any host-id assignment.

Default assignment: host_id = motor_id (reply id == data[0] — self
checking, no new id space). Reply-vs-command same-id collision is not a
concern: a motor's reply ends ~1 ms after its command; the next command
to that motor is a full tick (10 ms) away.

Usage (on the Pi, robot ON STAND, flight code stopped, motors powered;
motors do NOT need to be enabled — limp motors answer MIT frames):
    sudo python3 set_host_ids.py --show              # current reply ids
    sudo python3 set_host_ids.py --set --motor 102   # pilot, one motor
    sudo python3 set_host_ids.py --set               # all six
    sudo python3 set_host_ids.py --revert            # back to 0xFD
After --set: power-cycle motors, re-run --show — persistence across
power cycles is UNVERIFIED (Phase D3). If ids revert on power-up, the
setting must be saved via the vendor upper-computer tool instead.
"""

import argparse
import struct
import sys
import time

import config as C
from robstride_socketcan_driver import (
    CAN_ERR_FLAG, CAN_FRAME_FMT, CAN_FRAME_SIZE, CAN_RTR_FLAG,
    RobStrideSocketCanDriver,
)

FACTORY_HOST_ID = 0xFD
CMD9_TAIL = 0x01          # data[7] of the Modify-Host-CAN-ID frame
PROBE_WINDOW_S = 0.05
SETTLE_S = 0.05
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
