jiz322/tiptoe-biped/(commit log)

2026-09-24 Initial public release of TipToe (point-foot biped, sim2real research log)
    Curated snapshot of the private big_thigh repo as of 2026-09-24: hardware
    BOM and assembly notes, URDF/USD asset v2.7, Isaac Lab stand-up task with
    the belt-knee actuator model, deploy stack for the Raspberry Pi 5 over
    SocketCAN, the released checkpoint r1r_3150 (the 2026-09-03 stand), analysis
    scripts, campaign reports and the retrospective. History is not carried over.
2026-09-25 Release prep: GIFs, stand framing, BOM bearings and belts
    - README opens with the hardware balance GIF and a 2x2 of hardware shuffle,
    sim balance, sim stepping, sim seiza-to-stand (docs/img/).
    - Stand claims now state that the 6.06 s (09-03) and 8.79 s (09-06)
    recordings ended with the robot upright (operator stop after a tooth skip;
    drift into an obstacle), and list all five trials at the +0.089 trim.
    - 09-06 session outcomes recorded in data/README.md and the session README.
    - BOM: RA5008 hip-roll bearings (2 x 140) and HTD 5M belts (2 x 30) priced;
    totals 5360 -> 5700 in README, hardware/README.md, CITATION.cff.
    - Release v0.1.0 links filled in; *.gif marked binary.
    Co-Authored-B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
2026-09-25 add links, 3d print plates img
2026-10-19 Publish the October record: stand-up, stepping, sit; sim2real closed
    - docs/RETROSPECTIVE-2026-10.md (part II) plus the 16 campaign docs from 09-26 to 10-16, with their figures
    - README rewritten around the 2026-10-19 status: 3/5 stand-ups, 18.9 s and 43.6 s stepping ended by a commanded sit, the two plant corrections that closed sim2real, the knee-belt failure and the redesign
    - REPO_MAP: new topology, what the docs cite but this repo does not ship, updated trim/rate/belt facts
    - data/: six new session contracts (09-30 to 10-16), the Pi latency bench, updated session table and trim decode
    - CONTRIBUTING/ASSEMBLY/BOM/CITATION: open problems and belt notes moved to the 10-16 facts
